BME-SBT/canbrd_hardware/parts/218-8LPS/218-8.STEP

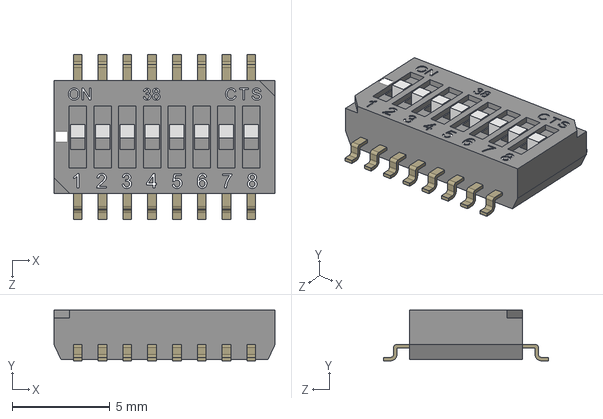
[picture p1: CAD file, 2022-01-22]
parts/218-8LPS/218-8.STEP
11.3 x 2.60 x 8.44 mm
