BME-SBT/canbrd_hardware/parts/Dc56-11.stp

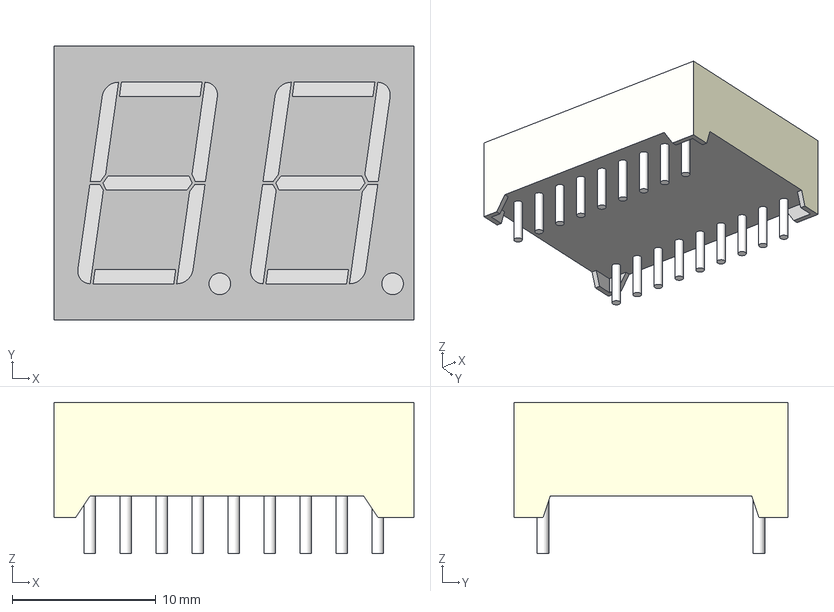
[picture p2: CAD file, 2022-10-08]
parts/Dc56-11.stp
25.0 x 19.0 x 10.5 mm
