BME-SBT/canbrd_hardware/parts/Littelfuse-154/0154.500DR.STEP

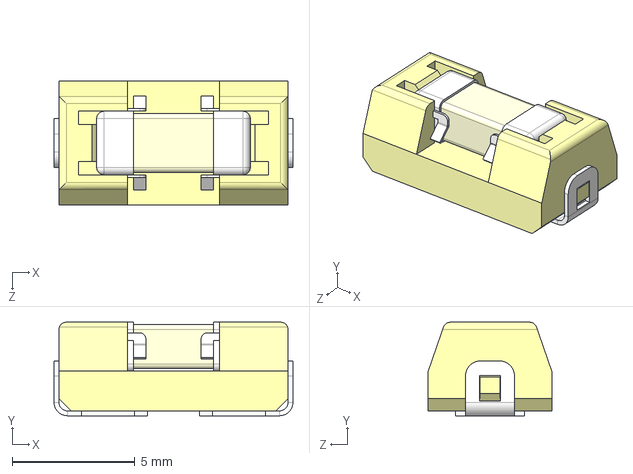
[picture p3: CAD file, 2022-01-22]
parts/Littelfuse-154/0154.500DR.STEP
9.73 x 3.81 x 5.03 mm
