BME-SBT/canbrd_hardware/parts/LTD-470/LTD-4708G.step

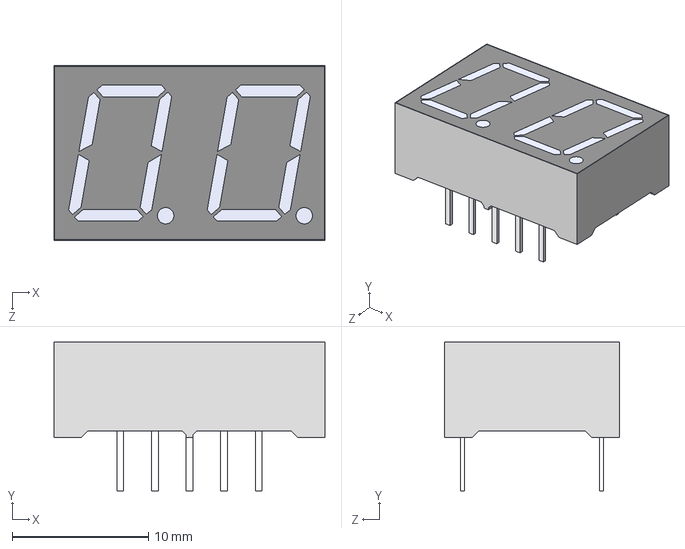
[picture p4: CAD file, 2022-01-22]
parts/LTD-470/LTD-4708G.step
19.9 x 10.9 x 12.8 mm
