BME-SBT/canbrd_hardware/parts/PTS815-SJ/PTS815SJM250SMTRLFS.stp

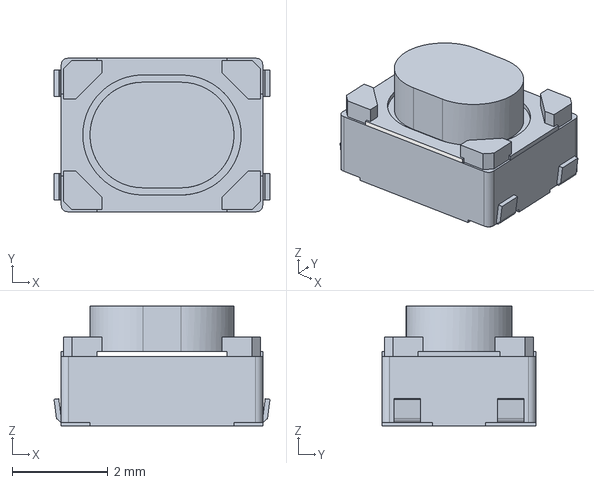
[picture p5: CAD file, 2022-01-22]
parts/PTS815-SJ/PTS815SJM250SMTRLFS.stp
4.50 x 3.20 x 2.50 mm
