BME-SBT/canbrd_hardware/parts/RFM-0505S/RFM-0505S.step

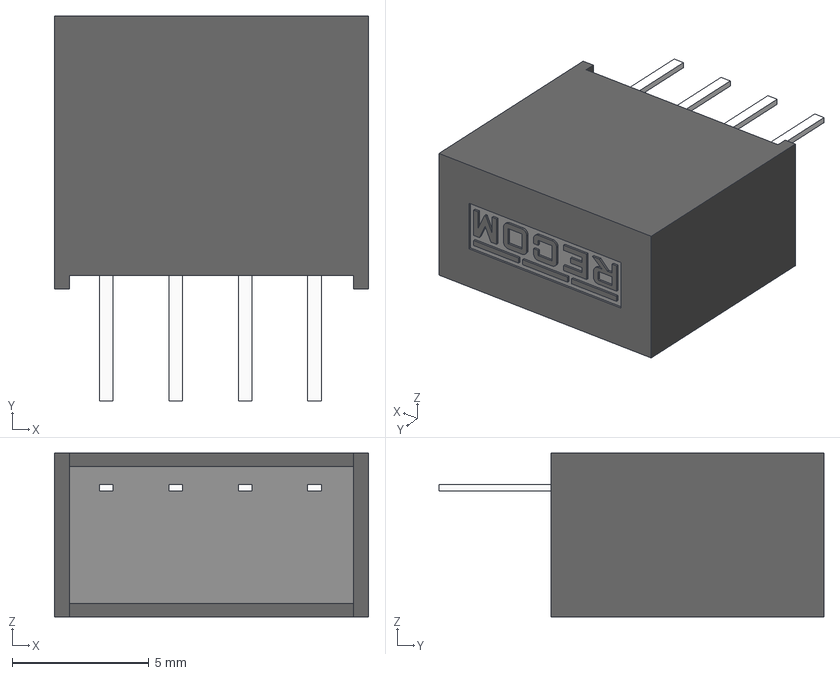
[picture p6: CAD file, 2022-05-23]
parts/RFM-0505S/RFM-0505S.step
11.5 x 14.1 x 6.00 mm
