BME-SBT/canbrd_hardware/parts/RP2040/RP2040.step

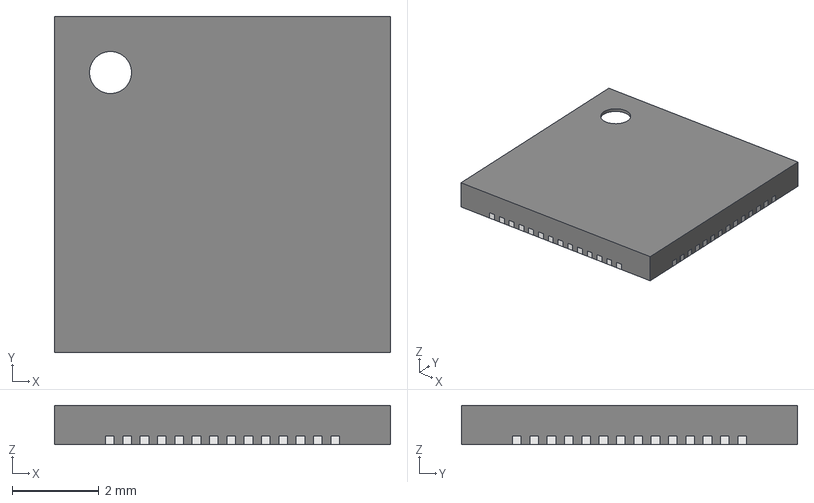
[picture p7: CAD file, 2022-01-22]
parts/RP2040/RP2040.step
7.75 x 7.75 x 0.901 mm
Open_CASCADE_STEP_translator_6.8_5.1
Open_CASCADE_STEP_translator_6.8_5.2.1
Thermal_Shape
Open_CASCADE_STEP_translator_6.8_5.4.1 x 56
