BME-SBT/canbrd_hardware/parts/SIC463/SiC462ED-T1-GE3.stp

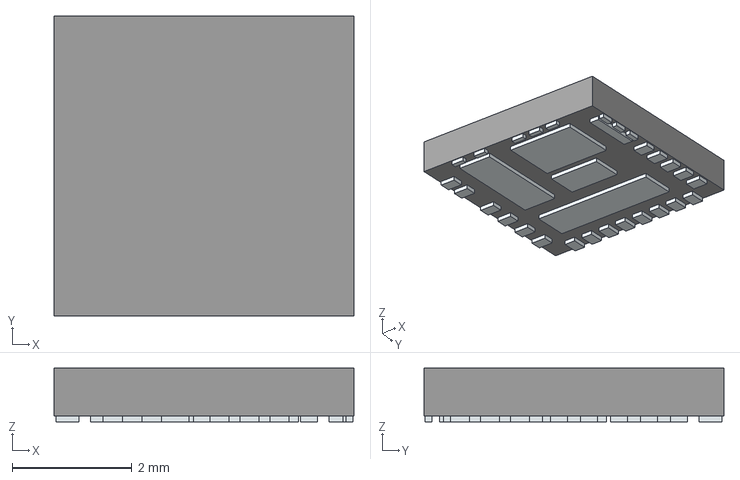
[picture p8: CAD file, 2022-01-28]
parts/SIC463/SiC462ED-T1-GE3.stp
5.00 x 5.00 x 0.9 mm
Pins
