BME-SBT/canbrd_hardware/parts/TBU-CA/tbu-ca-color.step

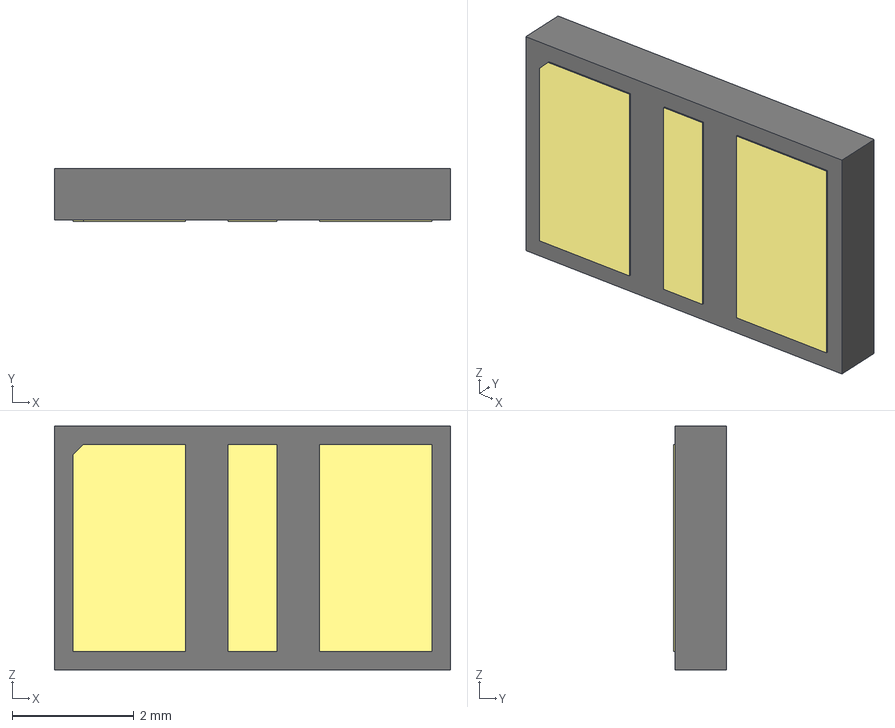
[picture p9: CAD file, 2022-02-24]
parts/TBU-CA/tbu-ca-color.step
6.50 x 0.875 x 4.00 mm
