BME-SBT/canbrd_hardware/parts/NRS5040T3R3NMGJ.stp

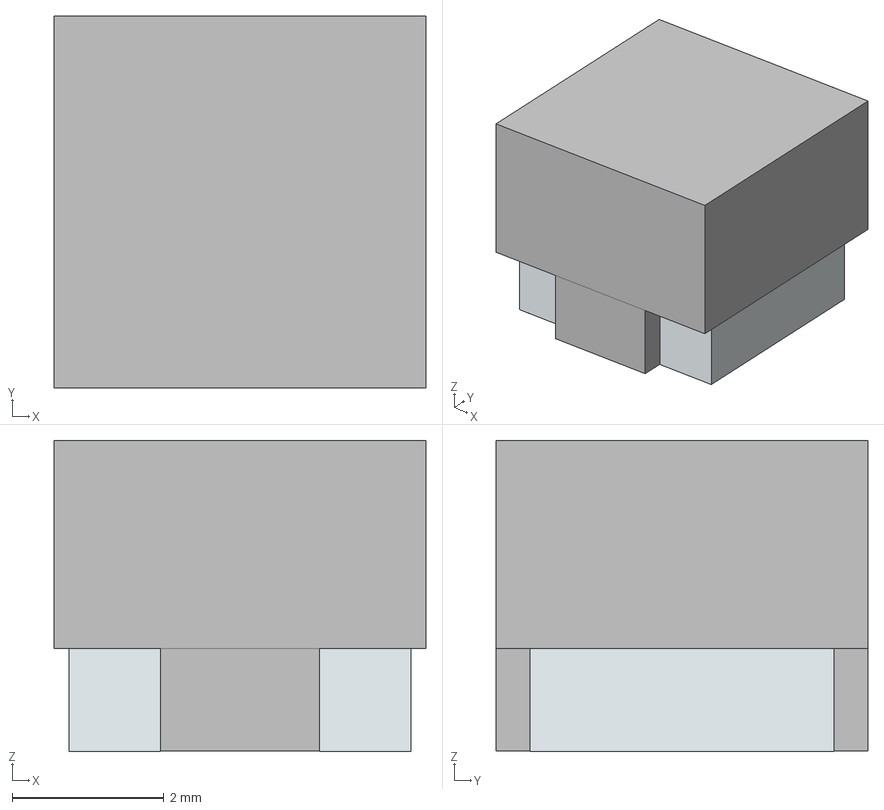
[picture p10: CAD file, 2022-02-24]
parts/NRS5040T3R3NMGJ.stp
4.90 x 4.90 x 4.10 mm
solidBody
solidLead
