BME-SBT/canbrd_hardware/parts/ASPI-0630HI.STEP

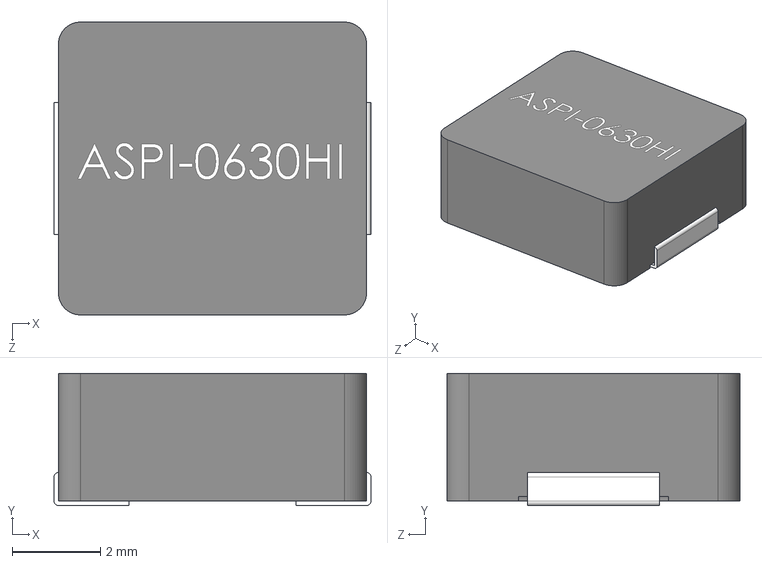
[picture p11: CAD file, 2022-02-24]
parts/ASPI-0630HI.STEP
7.20 x 3.00 x 6.65 mm
