BME-SBT/canbrd_hardware/parts/ASPIAIG-S4035.STEP

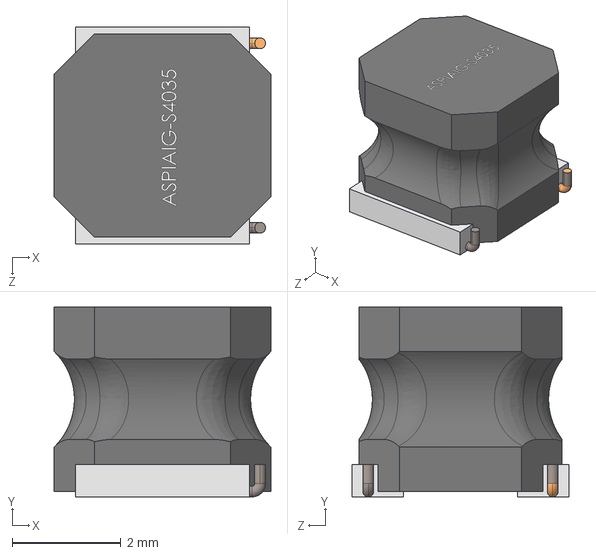
[picture p12: CAD file, 2022-02-24]
parts/ASPIAIG-S4035.STEP
4.00 x 3.50 x 4.00 mm
