BME-SBT/canbrd_hardware/parts/STP_WL-T7DS_0_39 (rev1).stp

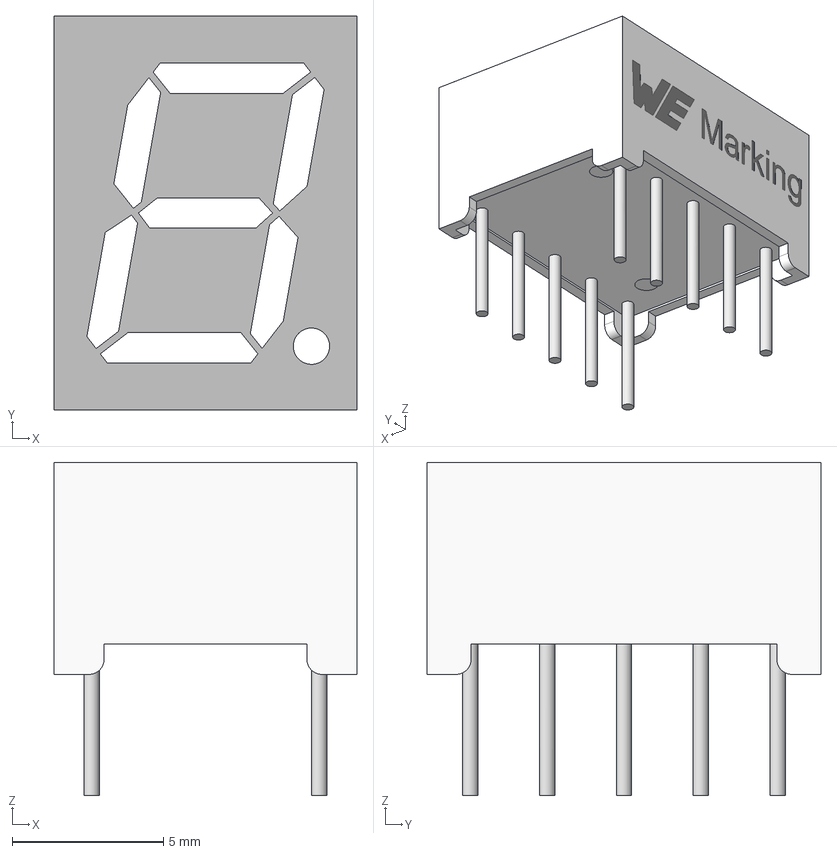
[picture p13: CAD file, 2022-01-28]
parts/STP_WL-T7DS_0_39 (rev1).stp
10.0 x 13.0 x 11.0 mm
Housing
PCB
Glue
