BME-SBT/canbrd_hardware/parts/MAX17634/MAX17634BATP_.step

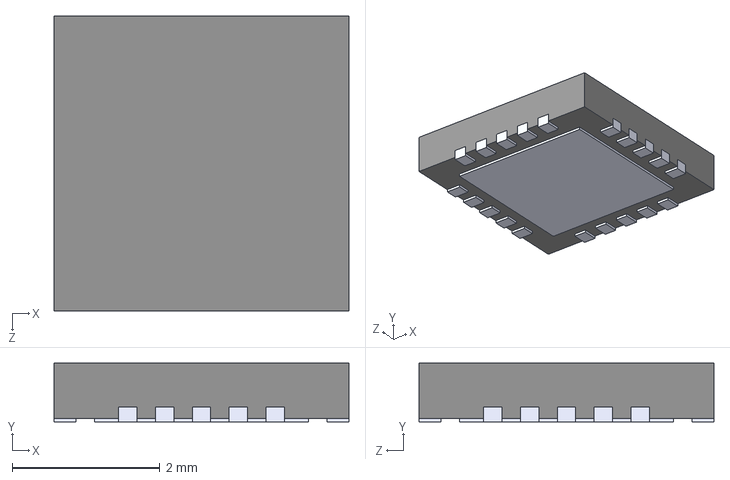
[picture p14: CAD file, 2022-02-24]
parts/MAX17634/MAX17634BATP_.step
4.00 x 0.8 x 4.00 mm
