BME-SBT/canbrd_hardware/(list of files, cad)

Other CAD files:
parts/TBU-CA/tbu-ca.stp
parts/SIC463/SiC462ED-T1-GE3.stl
