BME-SBT/canbrd_hardware/canbrd.pdf

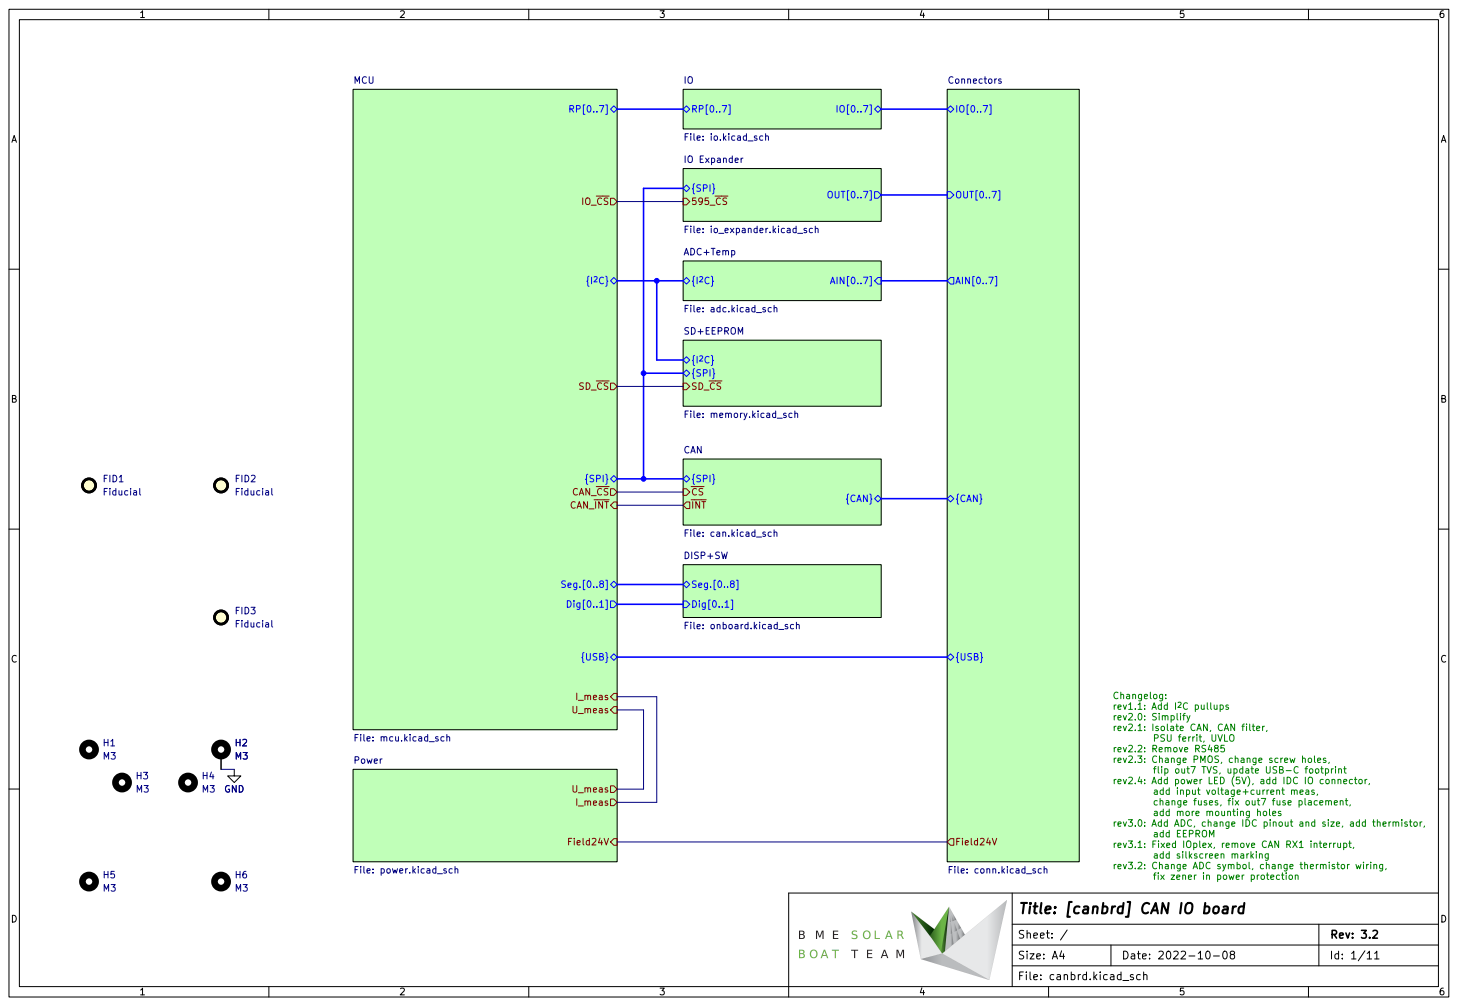
[picture p15: page 1]

rev1.1: Add I^{2}C pullups
rev2.0: Simplify
rev2.1: Isolate CAN, CAN filter,
PSU ferrit, UVLO
rev2.2: Remove RS485
rev2.3: Change PMOS, change screw holes,
flip out7 TVS, update USB-C footprint
rev2.4: Add power LED (5V), add IDC IO connector,
add input voltage+current meas,
change fuses, fix out7 fuse placement,
add more mounting holes
rev3.0: Add ADC, change IDC pinout and size, add thermistor,
add EEPROM
rev3.1: Fixed IOplex, remove CAN RX1 interrupt,
add silkscreen marking
rev3.2: Change ADC symbol, change thermistor wiring,

fix zener in power protection GND

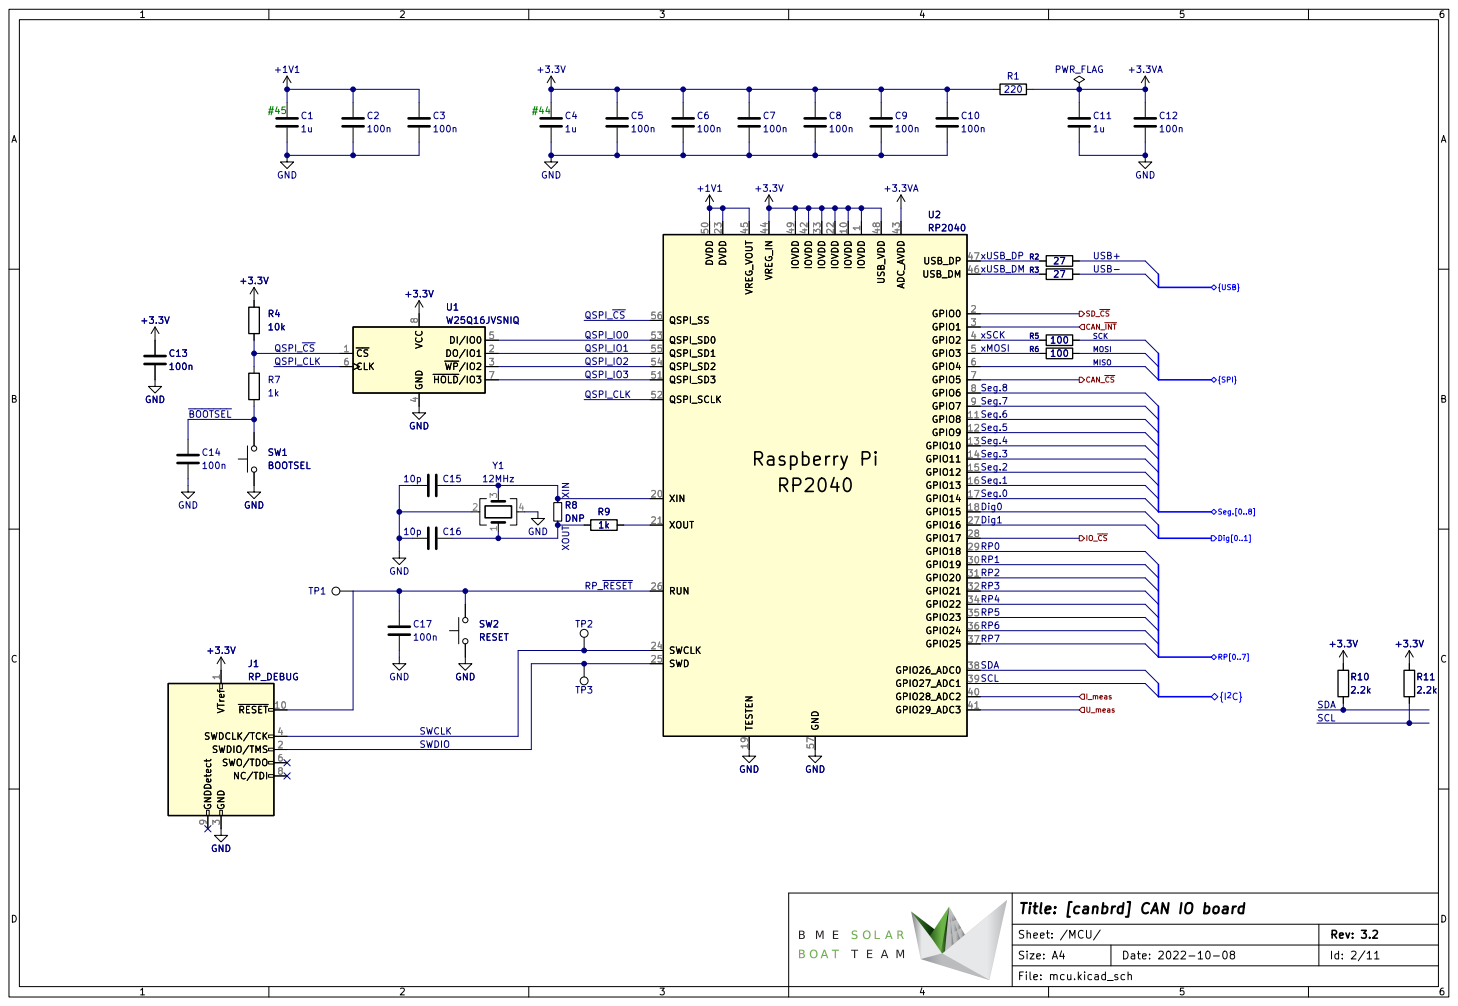
[picture p16: page 2]

1 IOVDD 10 GPIO8 11 GPIO9 12 GPIO10 13 GPIO11 14 GPIO12 15 GPIO13 16 GPIO14 17 GPIO15 18 TESTEN 19 GPIO0 2 XIN 20 XOUT 21 IOVDD 22 DVDD 23 SWCLK 24 SWD 25 RUN 26 GPIO16 27 GPIO17 28 GPIO18 29 GPIO1 3 GPIO19 30 GPIO20 31 GPIO21 32 IOVDD 33 GPIO22 34 GPIO23 35 GPIO24 36 GPIO25 37 GPIO26_ADC0 38 GPIO27_ADC1 39 GPIO2 4 GPIO28_ADC2 40 GPIO29_ADC3 41 IOVDD 42 ADC_AVDD 43 VREG_IN 44 VREG_VOUT 45 USB_DM 46 USB_DP 47 USB_VDD 48 IOVDD 49 GPIO3 5 DVDD 50 QSPI_SD3 51 QSPI_SCLK 52 QSPI_SD0 53 QSPI_SD2 54 QSPI_SD1 55 QSPI_SS 56 GND 57 GPIO4 6 GPIO5 7 GPIO6 8 GPIO7 9 U2RP2040

1 IOVDD 10 GPIO8 11 GPIO9 12 GPIO10 13 GPIO11 14 GPIO12 15 GPIO13 16 GPIO14 17 GPIO15 18 TESTEN 19 GPIO0 2 XIN 20 XOUT 21 IOVDD 22 DVDD 23 SWCLK 24 SWD 25 RUN 26 GPIO16 27 GPIO17 28 GPIO18 29 GPIO1 3 GPIO19 30 GPIO20 31 GPIO21 32 IOVDD 33 GPIO22 34 GPIO23 35 GPIO24 36 GPIO25 37 GPIO26_ADC0 38 GPIO27_ADC1 39 GPIO2 4 GPIO28_ADC2 40 GPIO29_ADC3 41 IOVDD 42 ADC_AVDD 43 VREG_IN 44 VREG_VOUT 45 USB_DM 46 USB_DP 47 USB_VDD 48 IOVDD 49 GPIO3 5 DVDD 50 QSPI_SD3 51 QSPI_SCLK 52 QSPI_SD0 53 QSPI_SD2 54 QSPI_SD1 55 QSPI_SS 56 GND 57 GPIO4 6 GPIO5 7 GPIO6 8 GPIO7 9 R4
+3.3V GND
SW1 BOOTSEL GND

4 DI/IO0 5 CLK 6 ~{HOLD}/IO3 7 VCC

3 SWDCLK/TCK 4 SWO/TDO 6 NC/TDI 8 GNDDetect 9 +3.3V GND

3 SWDCLK/TCK 4 SWO/TDO 6 NC/TDI 8 GNDDetect 9

File: mcu.kicad_sch Sheet: /MCU/

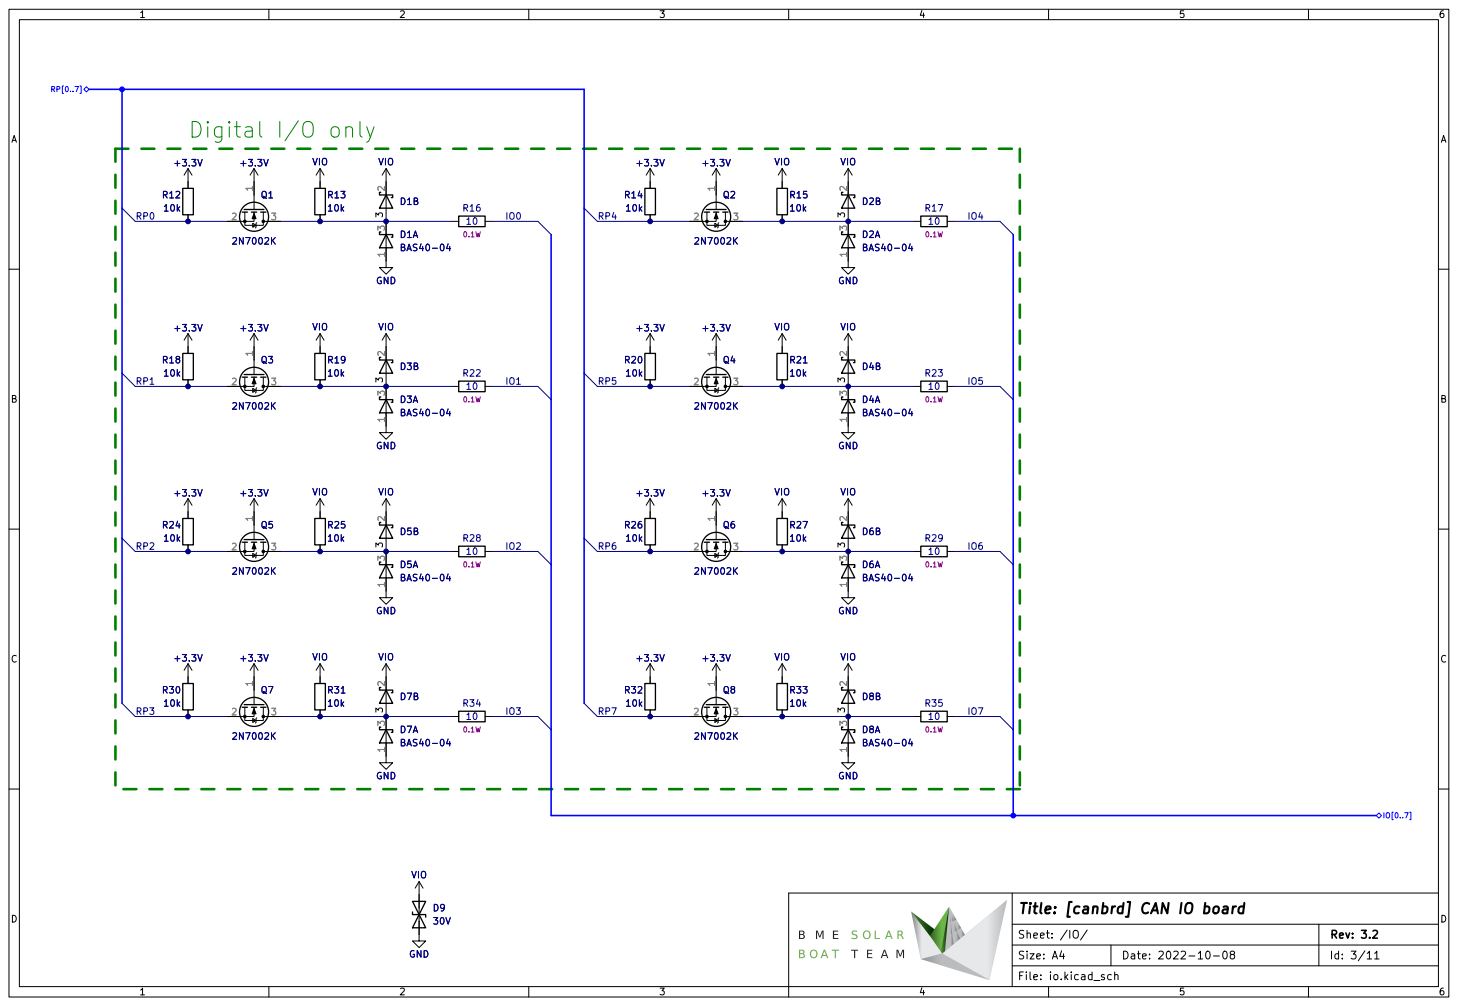
[picture p17: page 3]

File: io.kicad_sch Sheet: /IO/

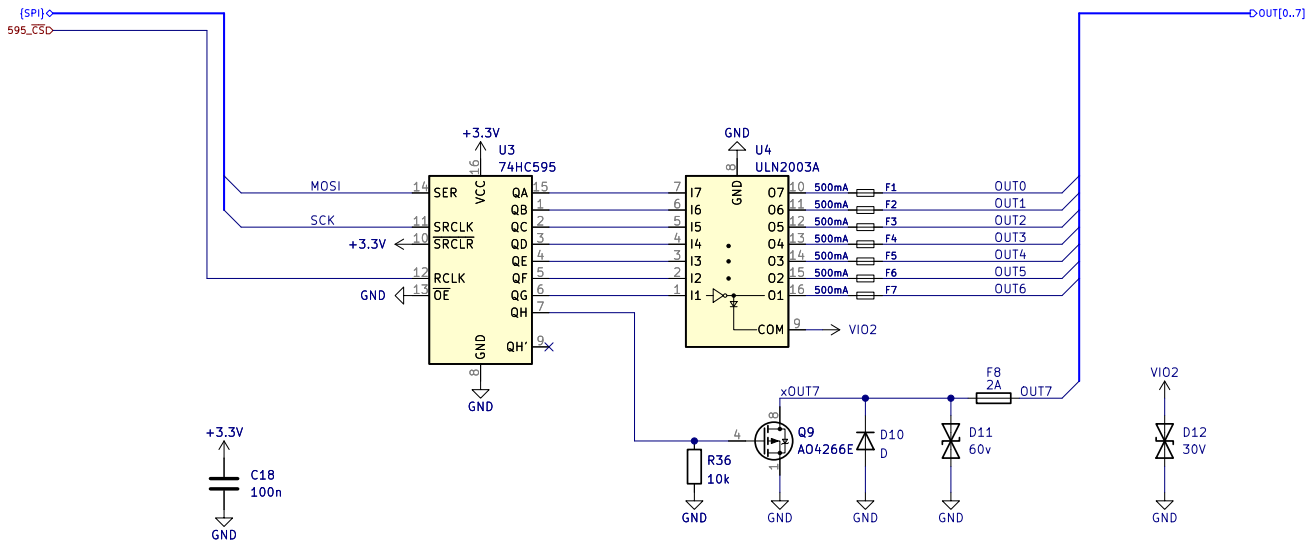
[picture p18: page 4]

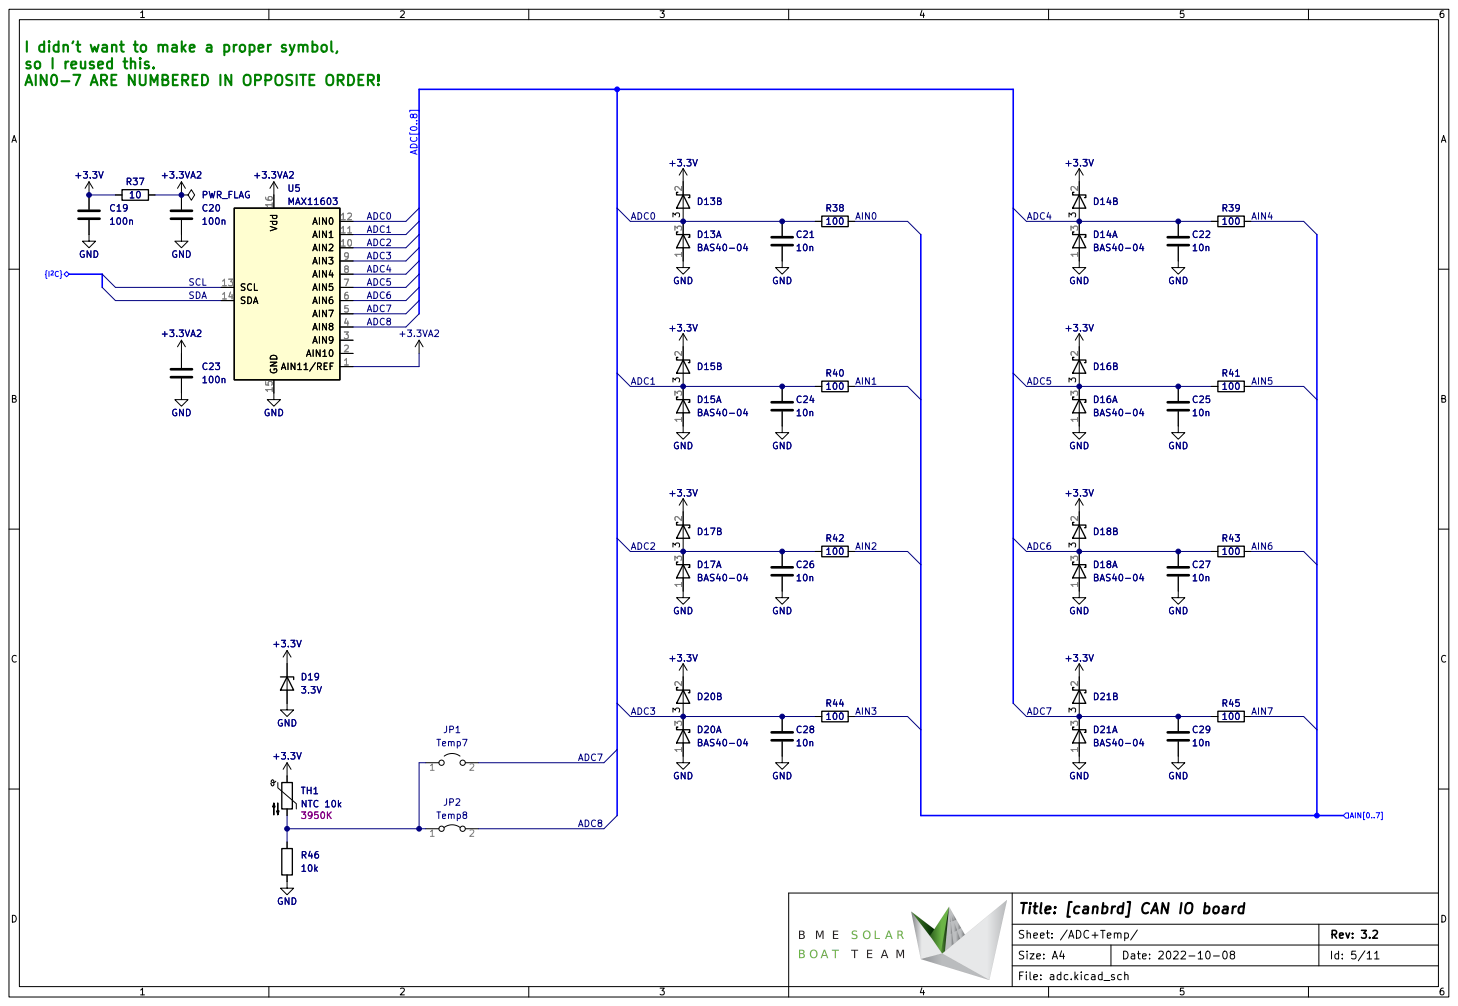
[picture p19: page 5]

I didn't want to make a proper symbol,
so I reused this.

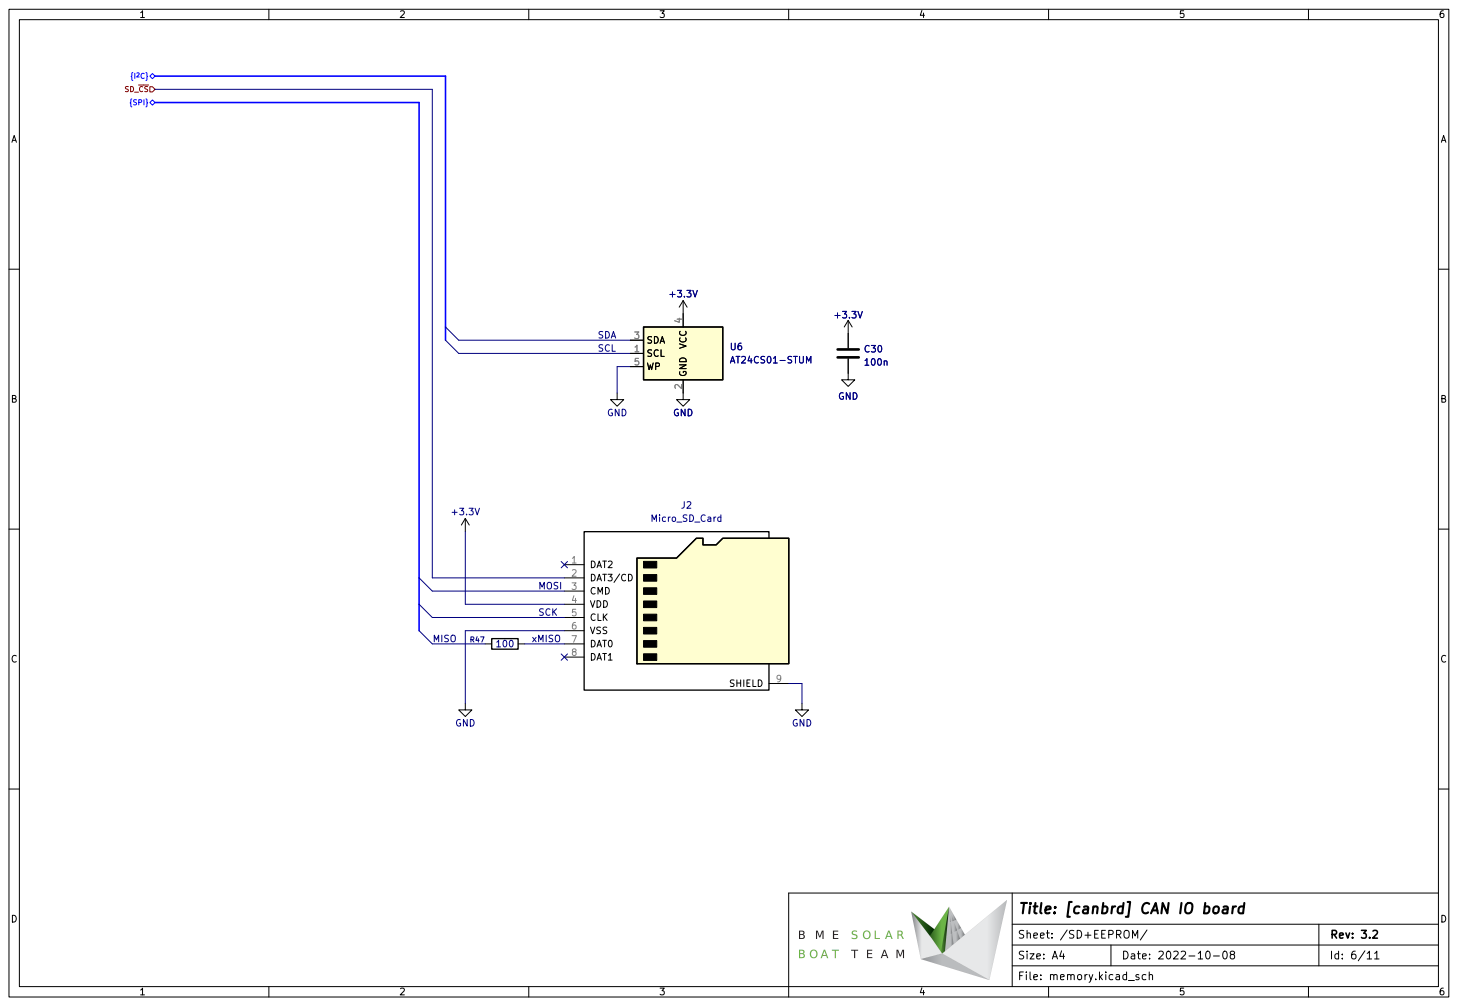
[picture p20: page 6]

File: memory.kicad_sch Sheet: /SD+EEPROM/

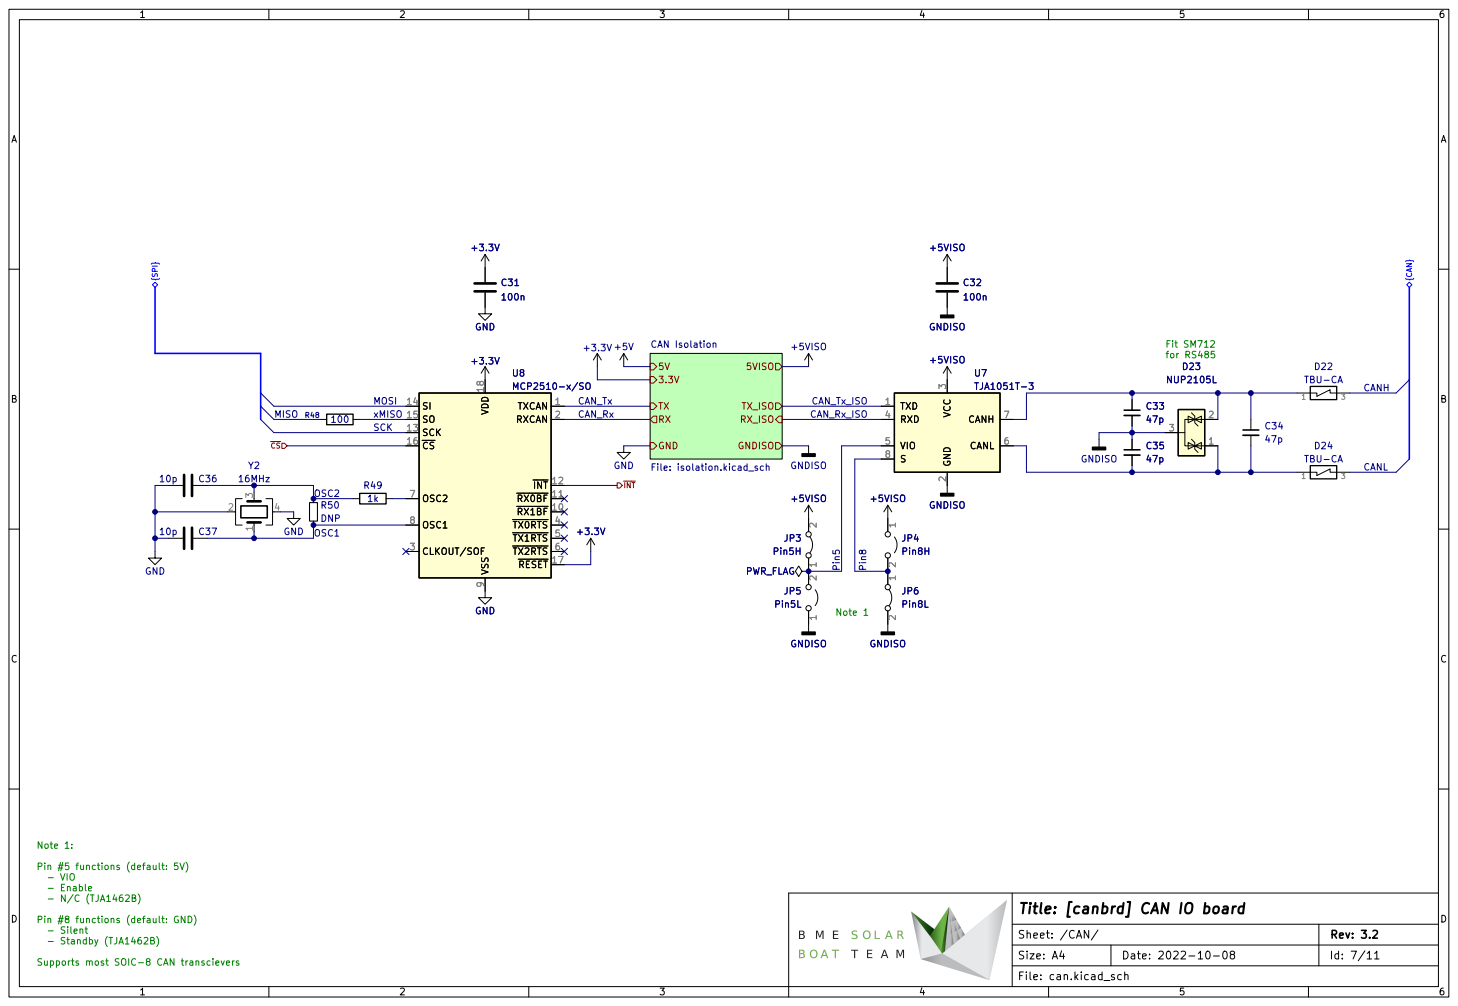
[picture p21: page 7]

for RS485 Note 1 Note 1: Pin #5 functions (default: 5V)

3 RXD 4 VIO 5 CANL 6 CANH 7 S

File: can.kicad_sch Sheet: /CAN/ GNDISO

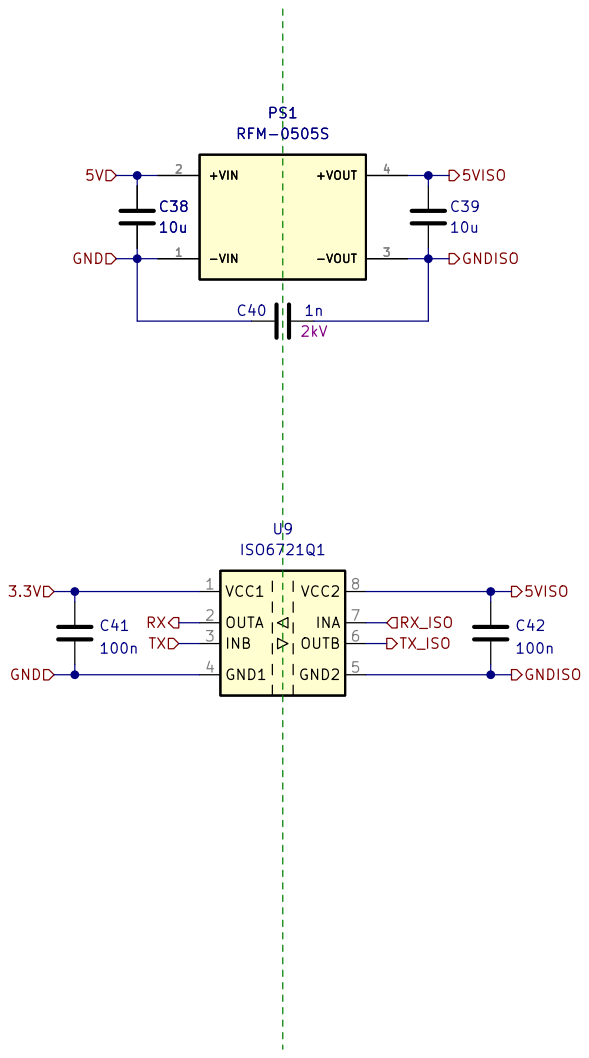
[picture p22: page 8]

File: isolation.kicad_sch Sheet: /CAN/CAN Isolation/

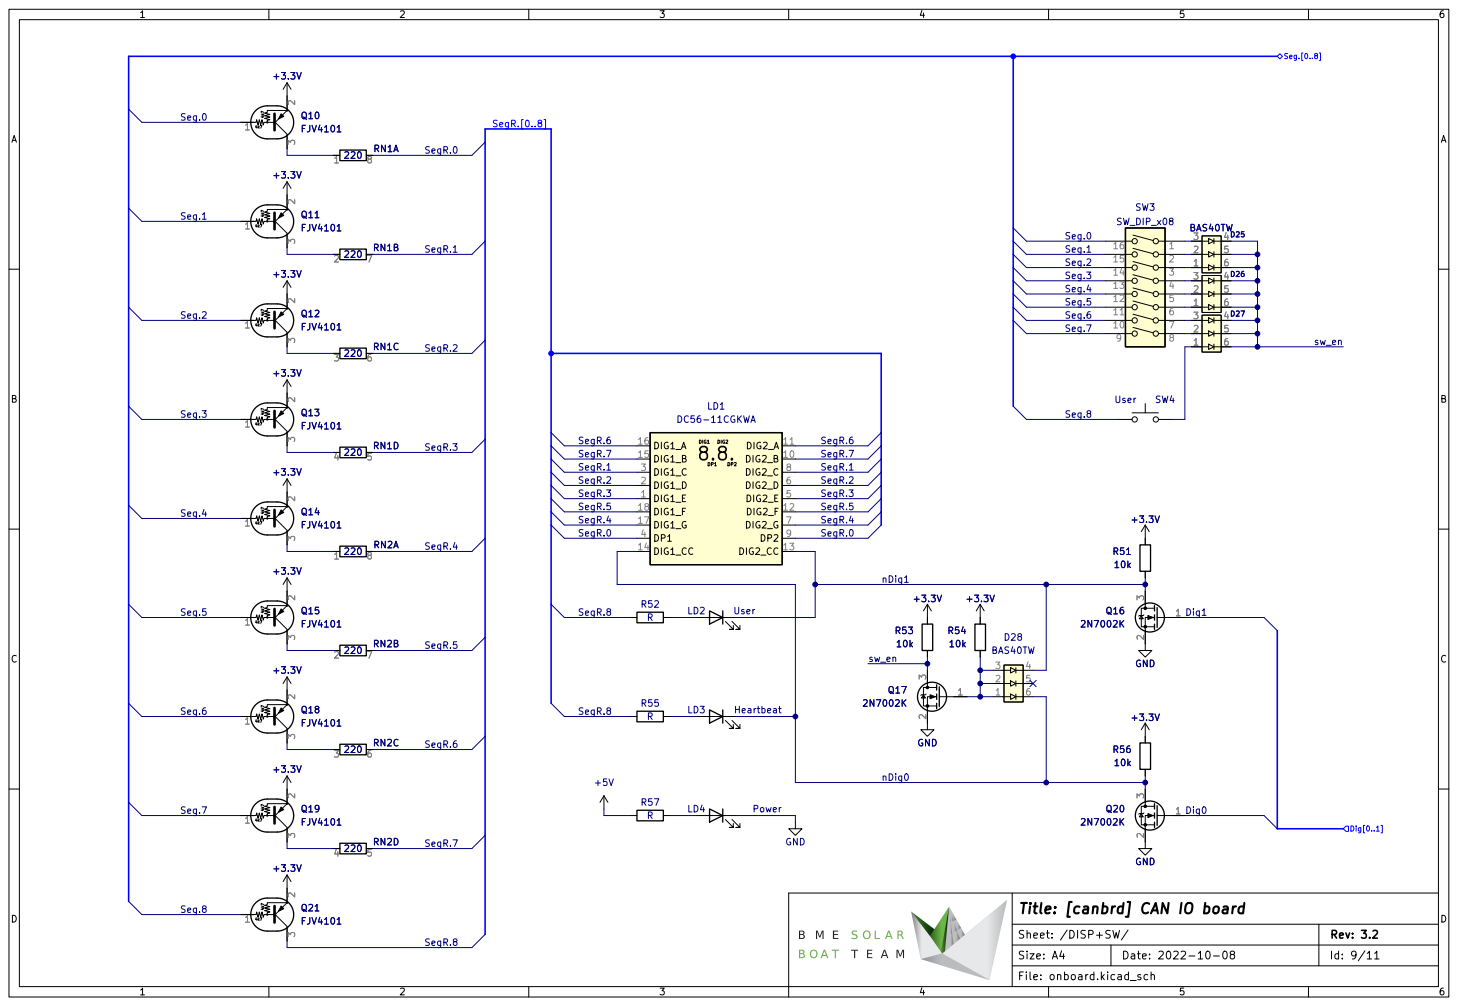
[picture p23: page 9]

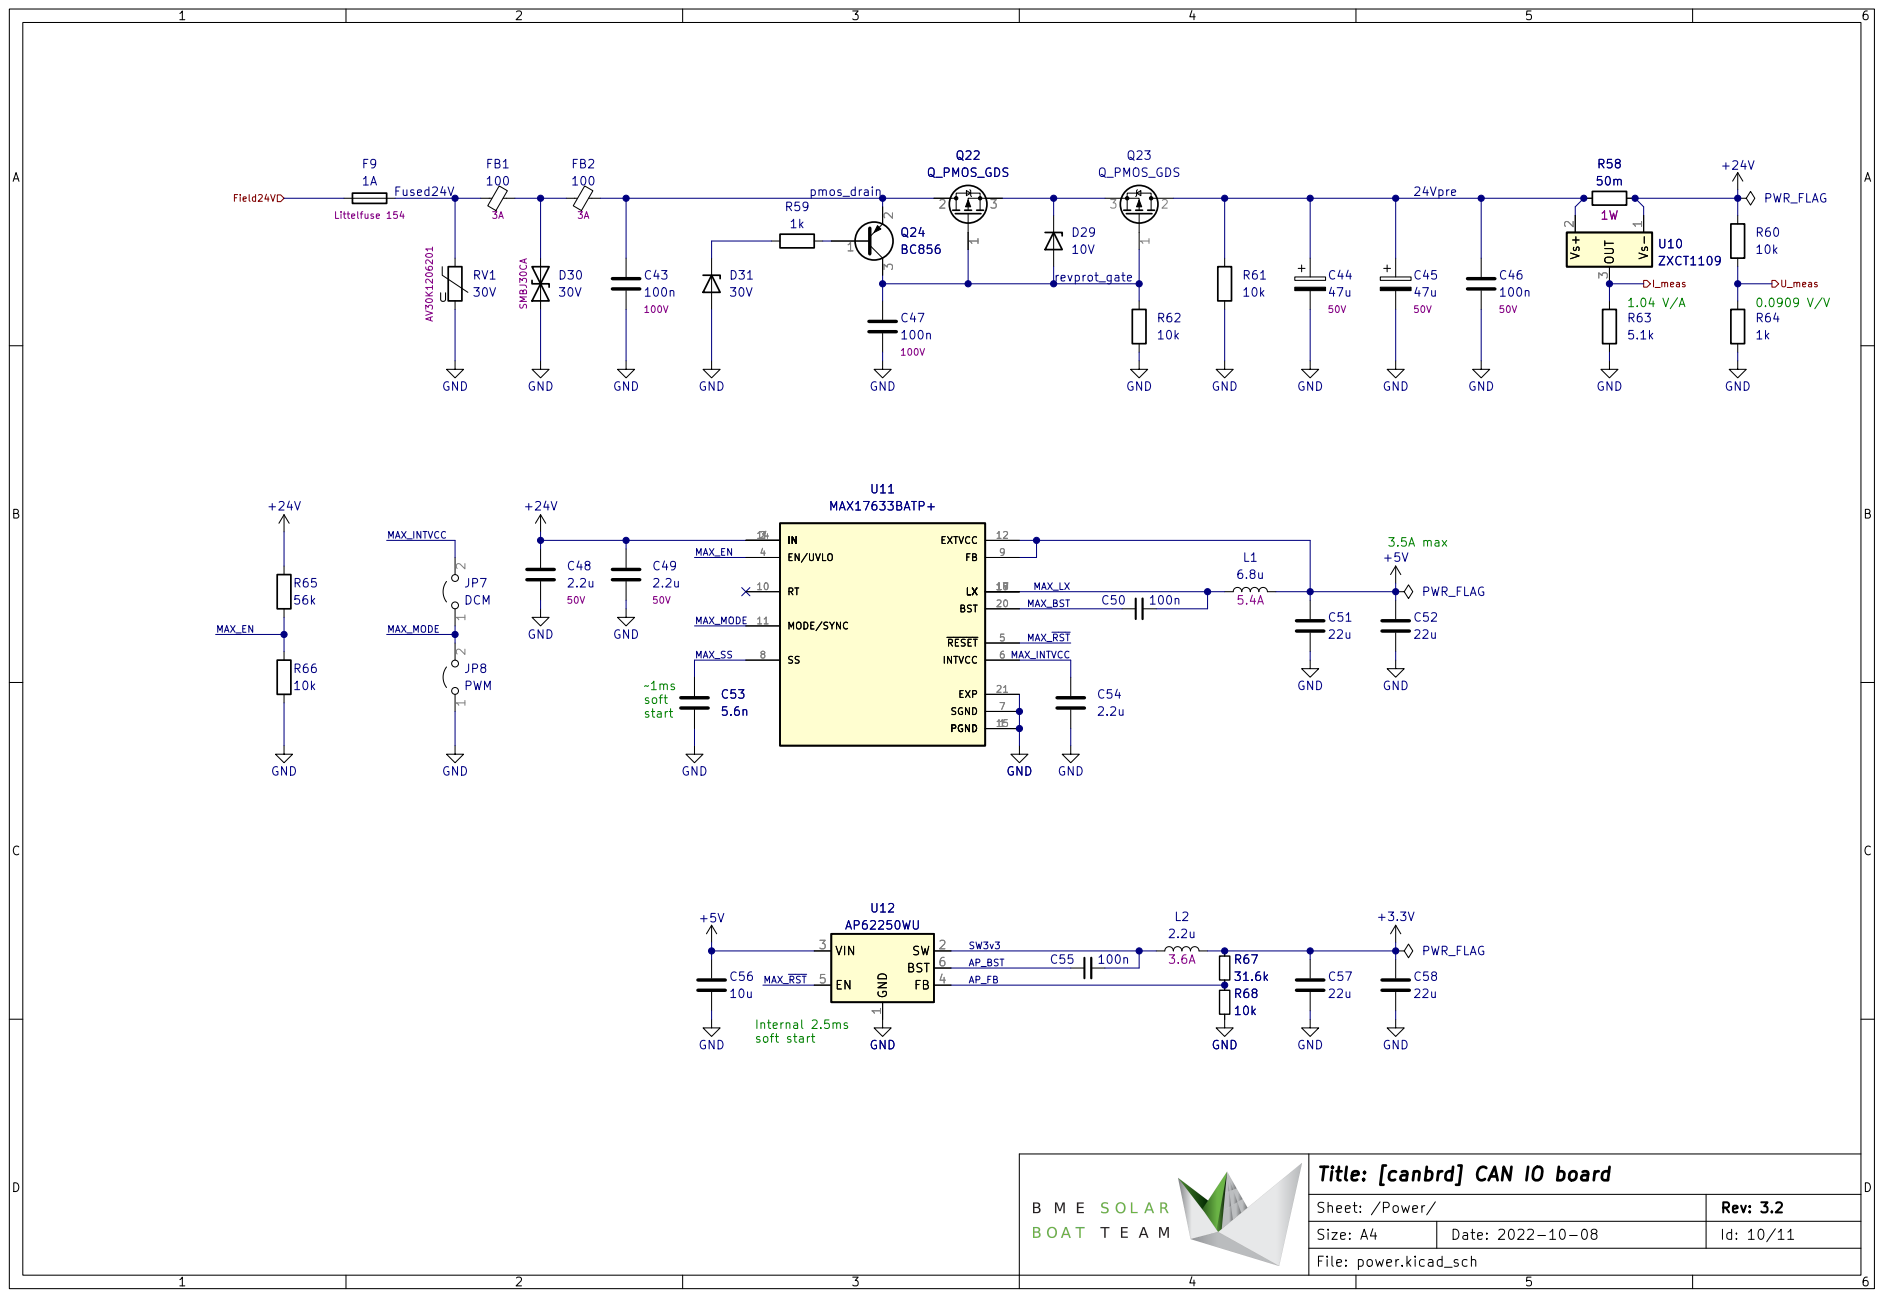
[picture p24: page 10]

File: power.kicad_sch Sheet: /Power/ C51

1 SW 2 VIN 3 FB 4 EN 5 BST 6 U12 AP62250WU

1 SW 2 VIN 3 FB 4 EN 5 BST 6 GND

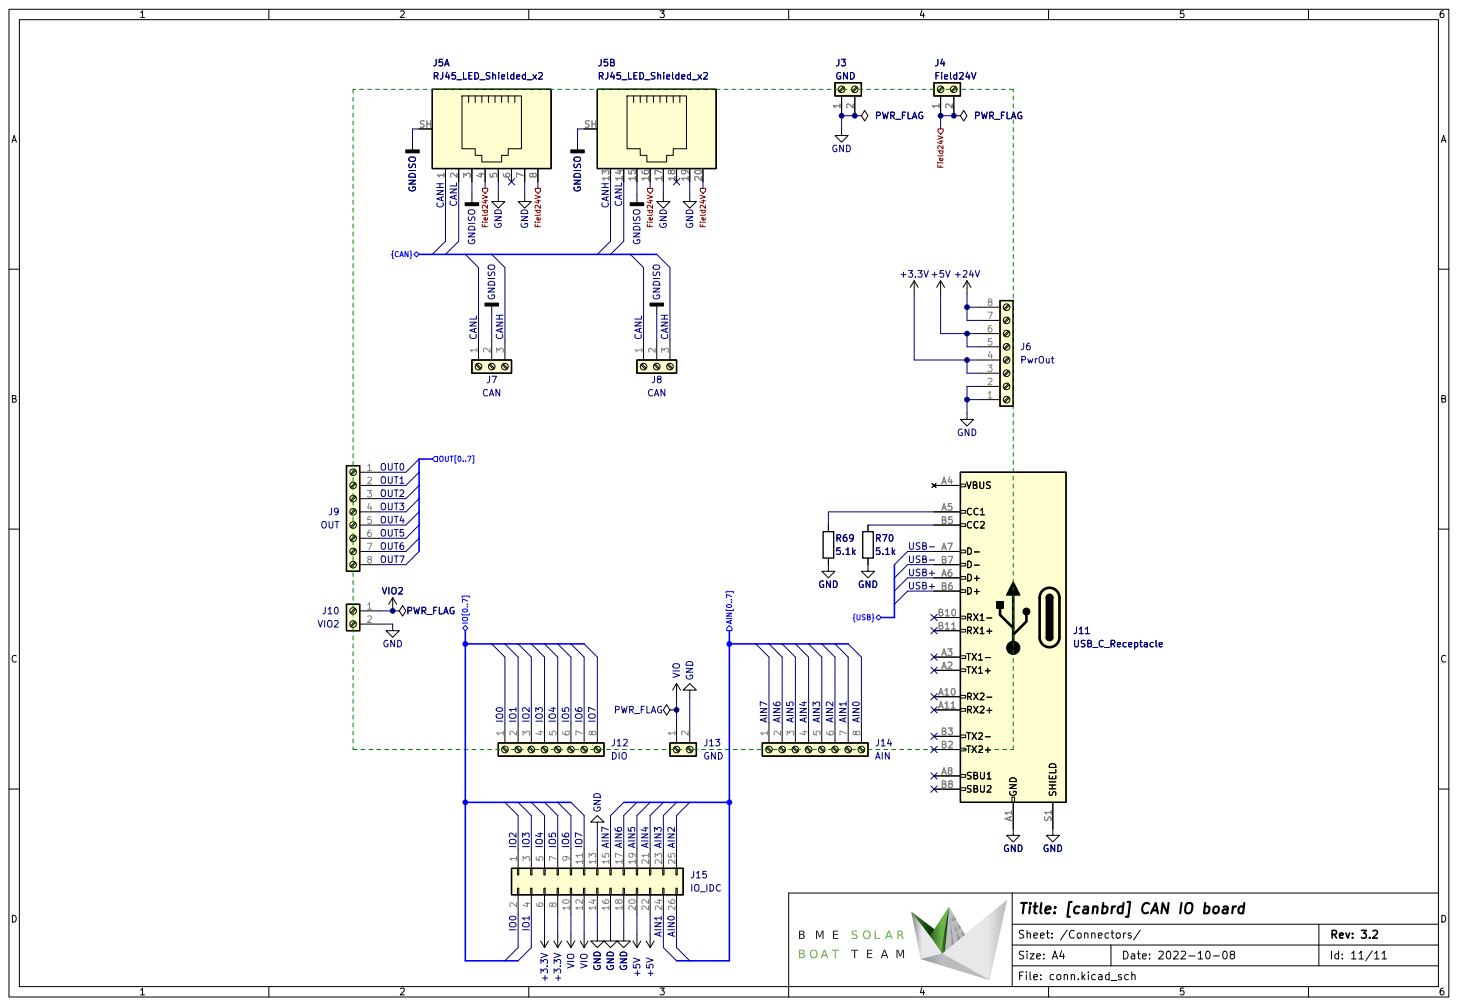
[picture p25: page 11]
