BME-SBT/canbrd_hardware/canbrd.kicad_pcb

## KiCad design canbrd.kicad_pcb (2022-06-03)

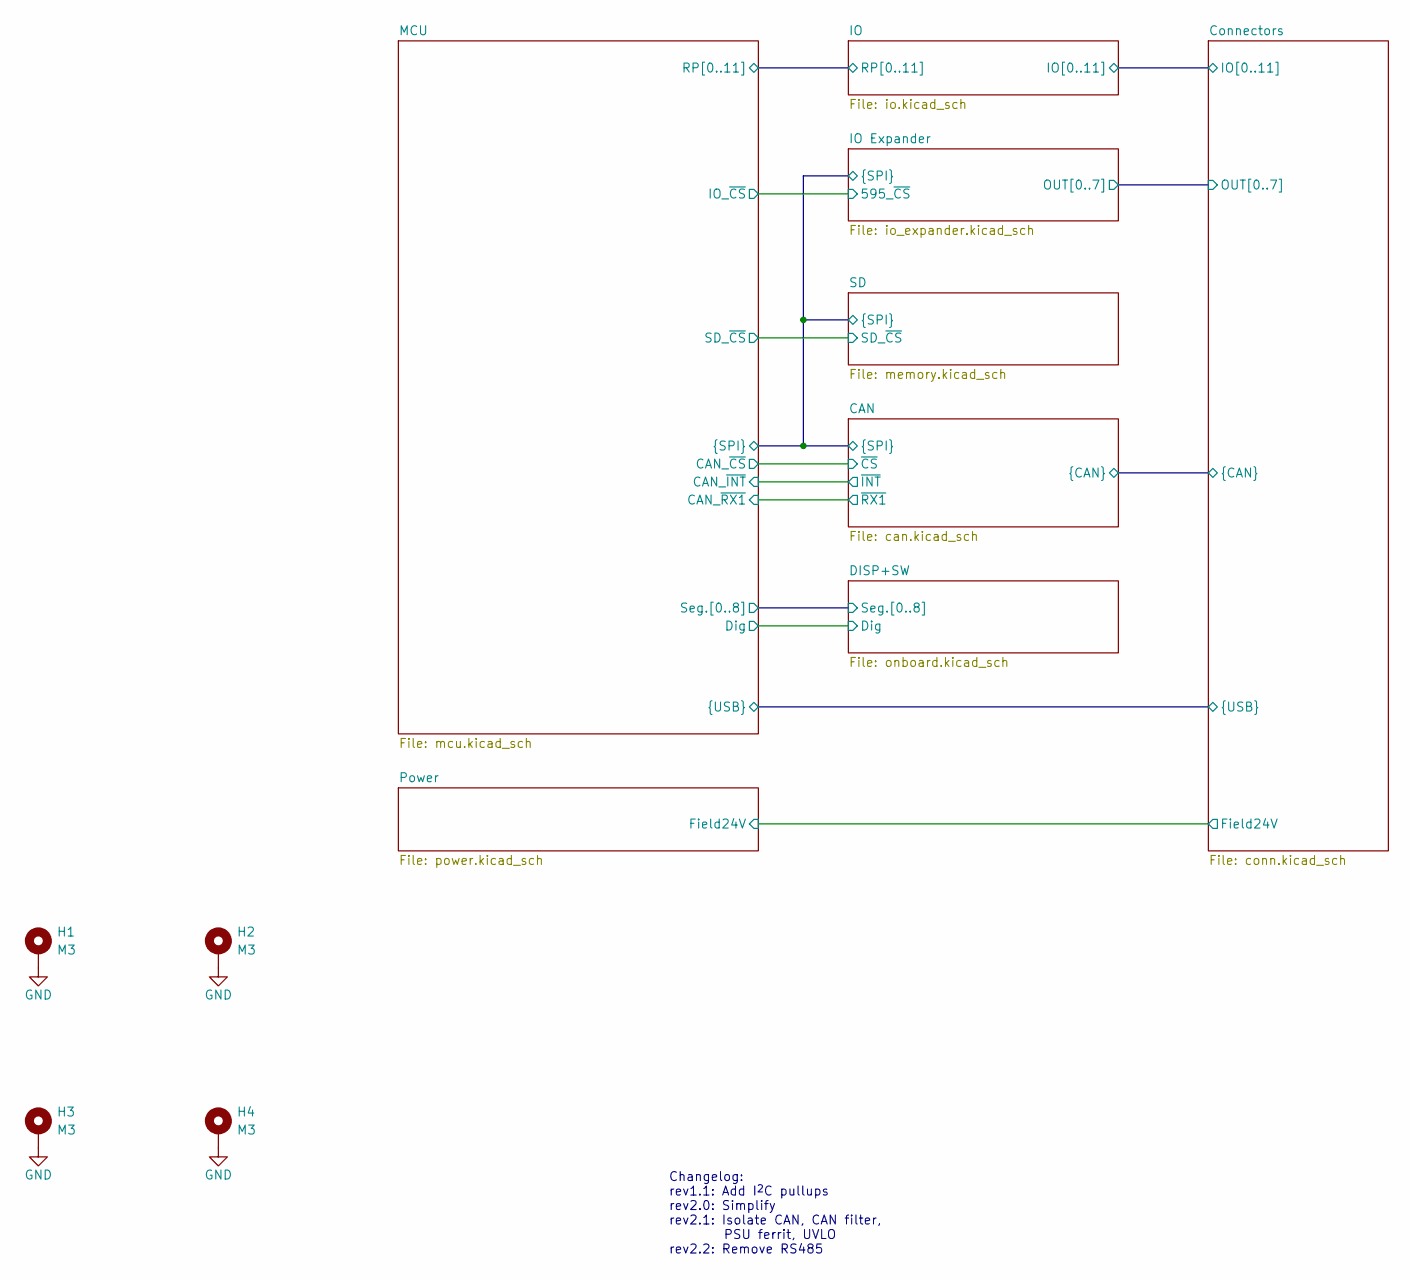
[picture p26: schematic canbrd.kicad_sch, [canbrd] CAN IO board]

Parts:
H1, H2, H3, H4: M3; MountingHole_3.2mm_M3_Pad_Via

Connections:
GND: H1.1, H2.1, H3.1, H4.1; also elsewhere on the board

Notes on the sheet:
Changelog: rev1.1: Add I^{2}C pullups rev2.0: Simplify rev2.1: Isolate CAN, CAN filter, PSU ferrit, UVLO rev2.2: Remove RS485

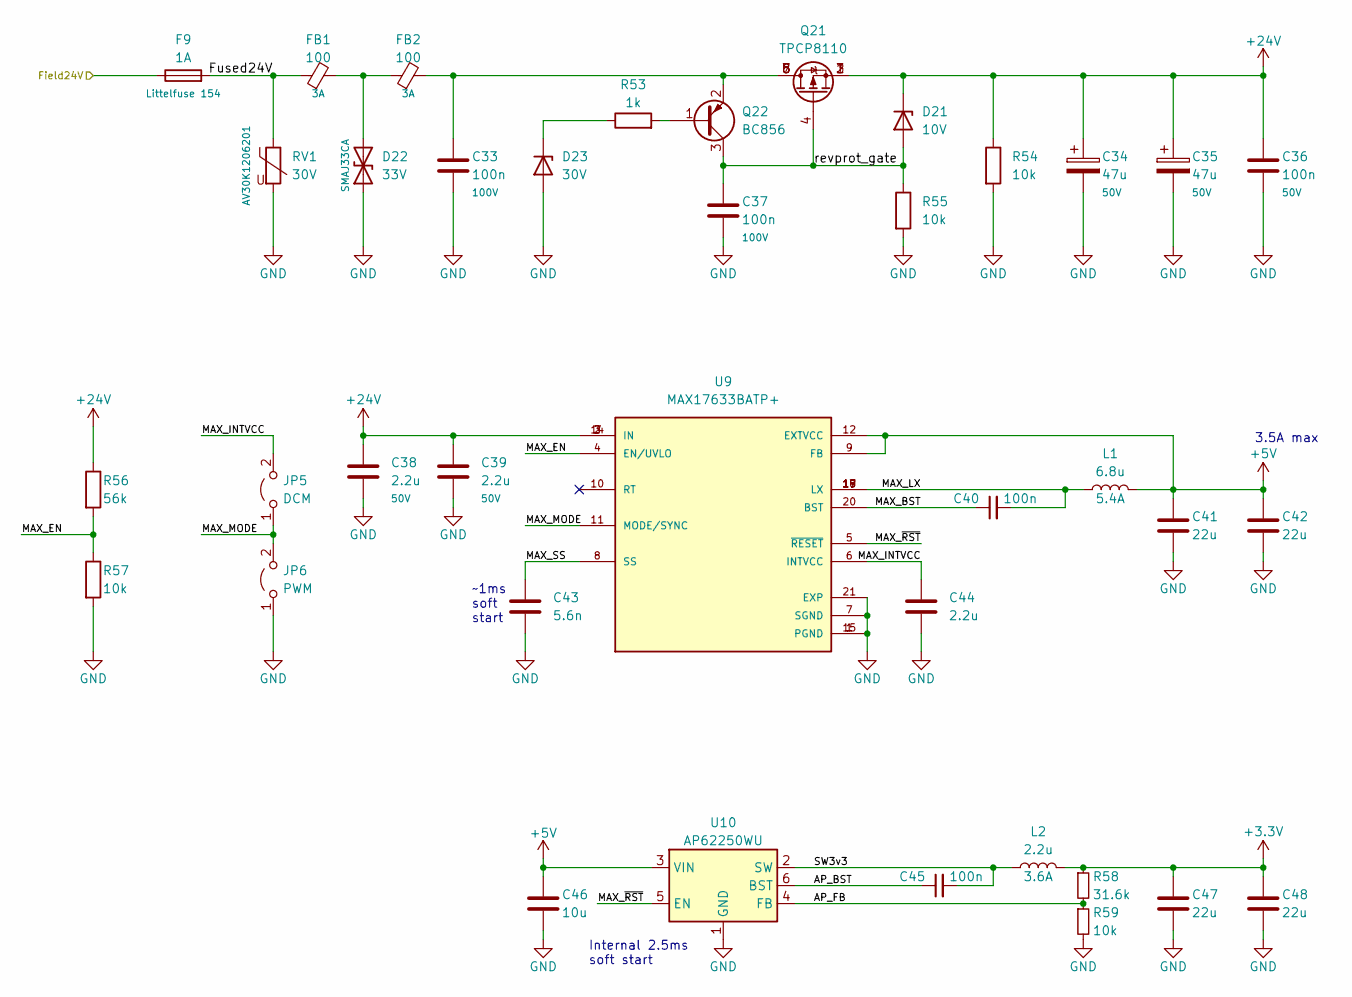
[picture p27: schematic power.kicad_sch, [canbrd] CAN IO board]

Parts:
C33, C37: 100n; C_1206_3216Metric; Voltage 100V
C34, C35: 47u; CP_Elec_8x6.5; Voltage 50V
C36: 100n; C_0805_2012Metric; Voltage 50V
C38, C39: 2.2u; C_1206_3216Metric; Voltage 50V
C40, C45: 100n; C_0603_1608Metric
C41, C42, C47, C48: 22u; C_0805_2012Metric
C43: 5.6n; C_0603_1608Metric
C44: 2.2u; C_0603_1608Metric
C46: 10u; C_0805_2012Metric
D21: 10V; D_SOD-123
D22: 33V; D_SMB
D23: 30V; D_SOD-123
F9: 1A; Littelfuse-154-2920
FB1, FB2: 100; L_1206_3216Metric
JP5: DCM; SolderJumper-2_P1.3mm_Open_TrianglePad1.0x1.5mm
JP6: PWM; SolderJumper-2_P1.3mm_Open_TrianglePad1.0x1.5mm
L1: 6.8u; L_Abracon_ASPI-0630LR
L2: 2.2u; L_Taiyo-Yuden_NR-50xx
Q21: TPCP8110; PS-8
Q22: BC856; SOT-23
R53: 1k; R_0603_1608Metric
R54, R55, R57, R59: 10k; R_0603_1608Metric
R56: 56k; R_0603_1608Metric
R58: 31.6k; R_0603_1608Metric
RV1: 30V; R_1206_3216Metric
U9: MAX17633BATP+; TQFN20-EP
U10: AP62250WU; TSOT26

Connections:
+3V3: C47.1, C48.1, L2.2, R58.1; also elsewhere on the board
+5V: C41.1, C42.1, C46.1, L1.2, U9.9 (FB), U9.12 (EXTVCC), U10.3 (VIN); also elsewhere on the board
+24V: C34.1, C35.1, C36.1, C38.1, C39.1, D21.1 (K), Q21.1 (S), Q21.2 (S), Q21.3 (S), R54.1, R56.1, U9.2 (IN), U9.3 (IN), U9.14 (IN); also elsewhere on the board
/Connectors/Field24V: F9.1; also elsewhere on the board
/Power/AP_BST: C45.1, U10.6 (BST)
/Power/AP_FB: R58.2, R59.1, U10.4 (FB)
/Power/Fused24V: F9.2, FB1.1, RV1.1
/Power/MAX_BST: C40.1, U9.20 (BST)
/Power/MAX_EN: R56.2, R57.1, U9.4 (EN/UVLO)
/Power/MAX_INTVCC: C44.1, JP5.2 (B), U9.6 (INTVCC)
/Power/MAX_LX: C40.2, L1.1, U9.17 (LX), U9.18 (LX), U9.19 (LX)
/Power/MAX_MODE: JP5.1 (A), JP6.2 (B), U9.11 (MODE/SYNC)
/Power/MAX_SS: C43.1, U9.8 (SS)
/Power/MAX_~RST: U9.5 (~RESET), U10.5 (EN)
/Power/SW3v3: C45.2, L2.1, U10.2 (SW)
/Power/revprot_gate: C37.1, D21.2 (A), Q21.4 (G), Q22.3 (C), R55.1
GND: C33.2, C34.2, C35.2, C36.2, C37.2, C38.2, C39.2, C41.2, C42.2, C43.2, C44.2, C46.2, C47.2, C48.2, D22.1 (A1), D23.2 (A), JP6.1 (A), R54.2, R55.2, R57.2, R59.2, RV1.2, U9.1 (PGND), U9.7 (SGND), U9.15 (PGND), U9.21 (EXP), U10.1 (GND); also elsewhere on the board
unnamed: C33.1, FB2.2, Q21.5 (D), Q21.6 (D), Q21.7 (D), Q21.8 (D), Q22.2 (E)
unnamed: D22.2 (A2), FB1.2, FB2.1
unnamed: D23.1 (K), R53.1
unnamed: Q22.1 (B), R53.2

Notes on the sheet:
~1ms soft start
3.5A max
Internal 2.5ms soft start

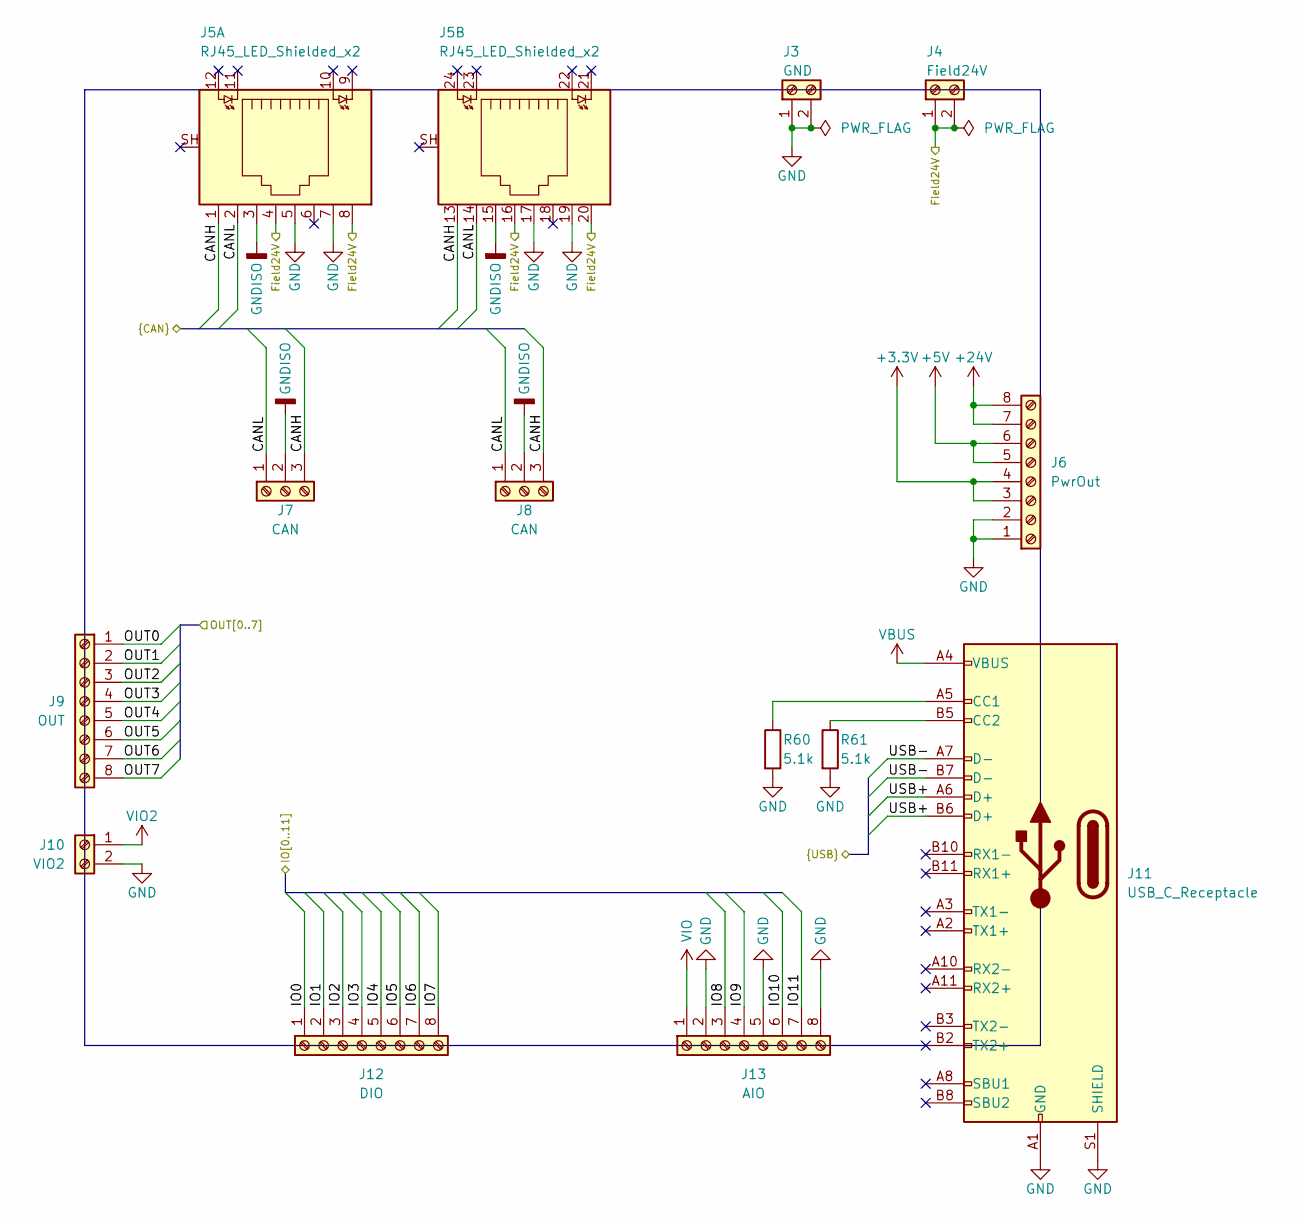
[picture p28: schematic conn.kicad_sch, [canbrd] CAN IO board]

Parts:
J3: GND; NH0210x0xxxxG
J4: Field24V; NH0210x0xxxxG
J5: RJ45_LED_Shielded_x2; RJ45_Amphenol_RJHSE5380-02
J6: PwrOut; NH0810x0xxxxG
J7, J8: CAN; NH0310x0xxxxG
J9: OUT; NH0810x0xxxxG
J10: VIO2; NH0210x0xxxxG
J11: USB_C_Receptacle; 10132328
J12: DIO; NH0810x0xxxxG
J13: AIO; NH0810x0xxxxG
R60, R61: 5.1k; R_0603_1608Metric

Connections:
+3V3: J6.3, J6.4; also elsewhere on the board
+5V: J6.5, J6.6; also elsewhere on the board
+24V: J6.7, J6.8; also elsewhere on the board
/CAN/CANH: J5.1, J5.13, J7.3, J8.3; also elsewhere on the board
/CAN/CANL: J5.2, J5.14, J7.1, J8.1; also elsewhere on the board
/Connectors/Field24V: J4.1, J4.2, J5.4, J5.8, J5.16, J5.20; also elsewhere on the board
/Connectors/IO0: J12.1; also elsewhere on the board
/Connectors/IO1: J12.2; also elsewhere on the board
/Connectors/IO2: J12.3; also elsewhere on the board
/Connectors/IO3: J12.4; also elsewhere on the board
/Connectors/IO4: J12.5; also elsewhere on the board
/Connectors/IO5: J12.6; also elsewhere on the board
/Connectors/IO6: J12.7; also elsewhere on the board
/Connectors/IO7: J12.8; also elsewhere on the board
/Connectors/IO8: J13.3; also elsewhere on the board
/Connectors/IO9: J13.4; also elsewhere on the board
/Connectors/IO10: J13.6; also elsewhere on the board
/Connectors/IO11: J13.7; also elsewhere on the board
/Connectors/OUT0: J9.1; also elsewhere on the board
/Connectors/OUT1: J9.2; also elsewhere on the board
/Connectors/OUT2: J9.3; also elsewhere on the board
/Connectors/OUT3: J9.4; also elsewhere on the board
/Connectors/OUT4: J9.5; also elsewhere on the board
/Connectors/OUT5: J9.6; also elsewhere on the board
/Connectors/OUT6: J9.7; also elsewhere on the board
/Connectors/OUT7: J9.8; also elsewhere on the board
/Connectors/USB+: J11.A6 (D+), J11.B6 (D+); also elsewhere on the board
/Connectors/USB-: J11.A7 (D-), J11.B7 (D-); also elsewhere on the board
GND: J3.1, J3.2, J5.5, J5.7, J5.17, J5.19, J6.1, J6.2, J10.2, J11.A1 (GND), J11.A12 (GND), J11.B1 (GND), J11.B12 (GND), J11.S1 (SHIELD), J13.2, J13.5, J13.8, R60.2, R61.2; also elsewhere on the board
GNDISO: J5.3, J5.15, J7.2, J8.2; also elsewhere on the board
unnamed: J11.A5 (CC1), R60.1
unnamed: J11.B5 (CC2), R61.1
VBUS: J11.A4 (VBUS), J11.A9 (VBUS), J11.B4 (VBUS), J11.B9 (VBUS)
VIO: J13.1; also elsewhere on the board
VIO2: J10.1; also elsewhere on the board

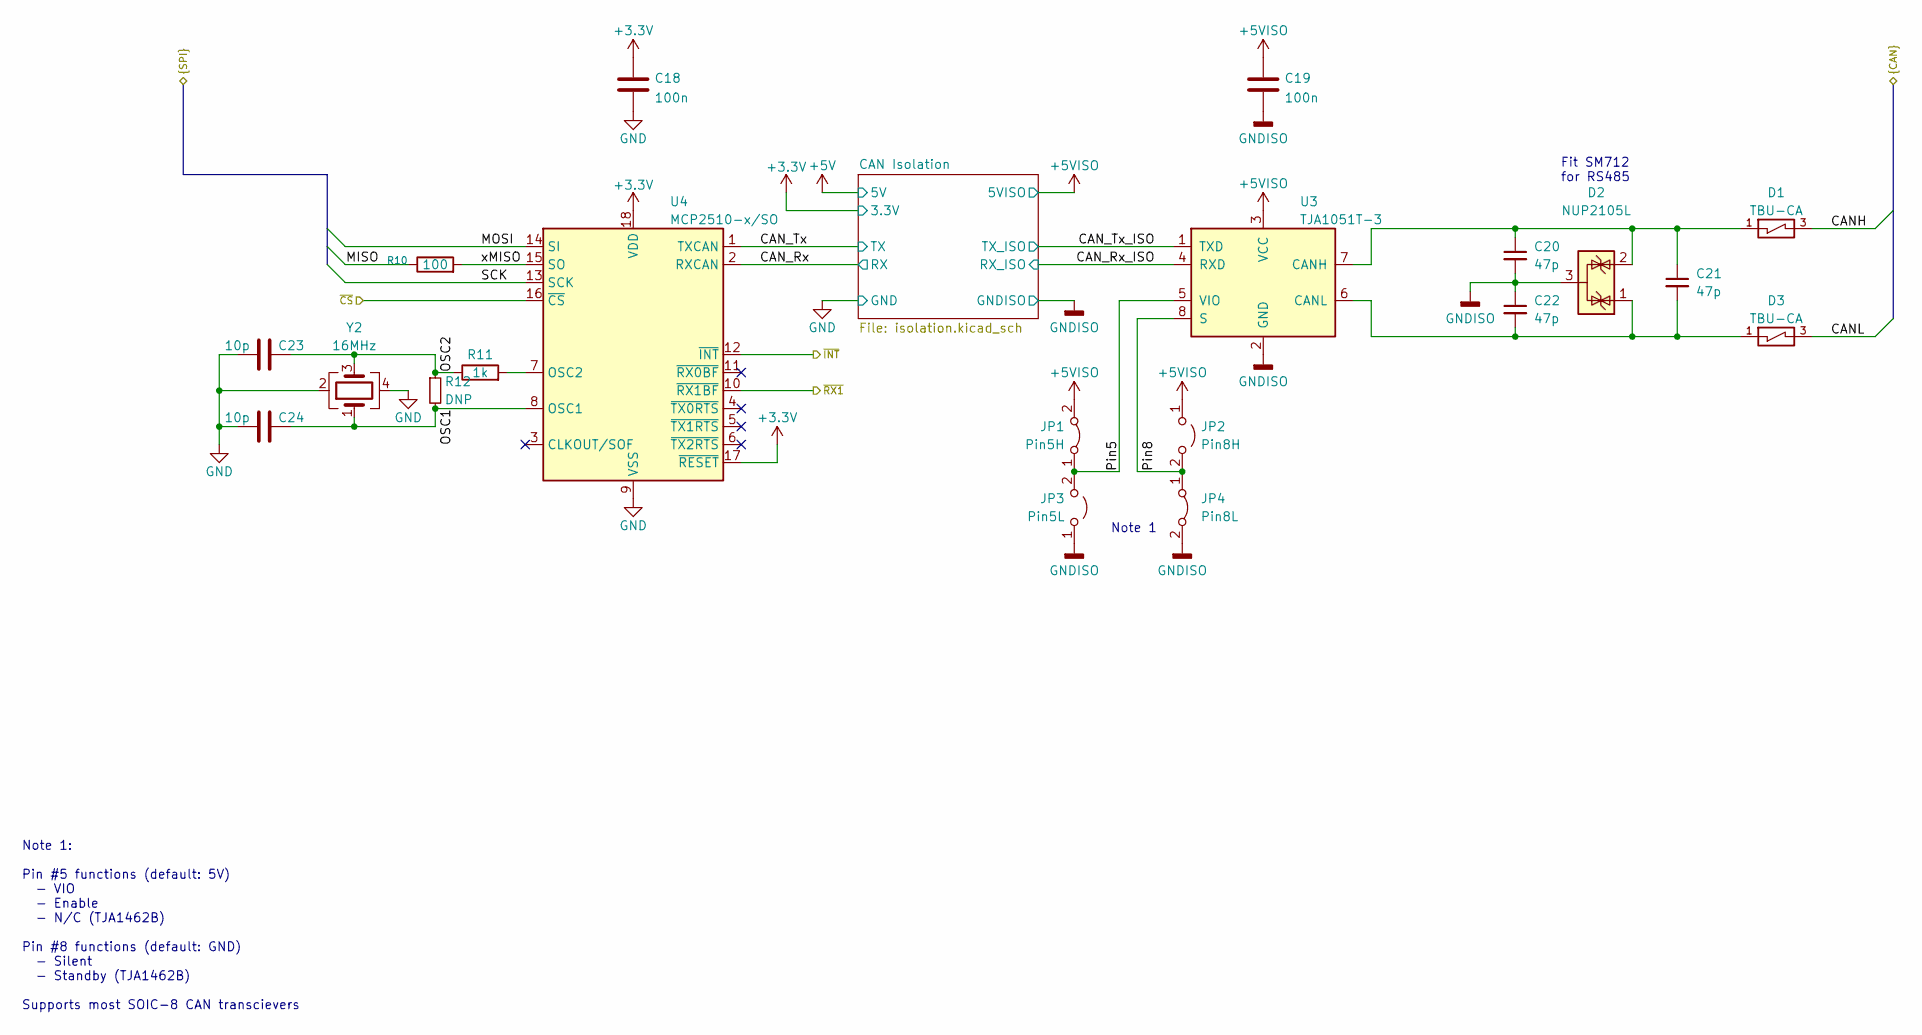
[picture p29: schematic can.kicad_sch, [canbrd] CAN IO board]

Parts:
C18, C19: 100n; C_0603_1608Metric
C20, C21, C22: 47p; C_0603_1608Metric
C23, C24: 10p; C_0603_1608Metric
D1, D3: TBU-CA; DIOC650X400X100N
D2: NUP2105L; SOT-23
JP1: Pin5H; SolderJumper-2_P1.3mm_Bridged_Pad1.0x1.5mm
JP2: Pin8H; SolderJumper-2_P1.3mm_Open_TrianglePad1.0x1.5mm
JP3: Pin5L; SolderJumper-2_P1.3mm_Open_TrianglePad1.0x1.5mm
JP4: Pin8L; SolderJumper-2_P1.3mm_Bridged_Pad1.0x1.5mm
R10: 100; R_0603_1608Metric
R11: 1k; R_0603_1608Metric
R12: DNP; R_0603_1608Metric
U3: TJA1051T-3; SOIC-8_3.9x4.9mm_P1.27mm
U4: MCP2510-x/SO; SOIC-18W_7.5x11.6mm_P1.27mm
Y2: 16MHz; Crystal_SMD_3225-4Pin_3.2x2.5mm

Connections:
+3V3: C18.1, U4.17 (~RESET), U4.18 (VDD); also elsewhere on the board
+5VISO: C19.1, JP1.2 (B), JP2.1 (A), U3.3 (VCC); also elsewhere on the board
/CAN/CANH: D1.3; also elsewhere on the board
/CAN/CANL: D3.3; also elsewhere on the board
/CAN/CAN_Rx: U4.2 (RXCAN); also elsewhere on the board
/CAN/CAN_Rx_ISO: U3.4 (RXD); also elsewhere on the board
/CAN/CAN_Tx: U4.1 (TXCAN); also elsewhere on the board
/CAN/CAN_Tx_ISO: U3.1 (TXD); also elsewhere on the board
/CAN/MISO: R10.1; also elsewhere on the board
/CAN/MOSI: U4.14 (SI); also elsewhere on the board
/CAN/OSC1: C24.2, R12.2, U4.8 (OSC1), Y2.1
/CAN/OSC2: C23.2, R11.1, R12.1, Y2.3
/CAN/Pin5: JP1.1 (A), JP3.2 (B), U3.5 (VIO)
/CAN/Pin8: JP2.2 (B), JP4.1 (A), U3.8 (S)
/CAN/SCK: U4.13 (SCK); also elsewhere on the board
/CAN/xMISO: R10.2, U4.15 (SO)
/CAN/~CS: U4.16 (~CS); also elsewhere on the board
/CAN/~INT: U4.12 (~INT); also elsewhere on the board
/CAN/~RX1: U4.10 (~RX1BF); also elsewhere on the board
GND: C18.2, C23.1, C24.1, U4.9 (VSS), Y2.2, Y2.4; also elsewhere on the board
GNDISO: C19.2, C20.2, C22.1, D2.3 (A), JP3.1 (A), JP4.2 (B), U3.2 (GND); also elsewhere on the board
unnamed: C20.1, C21.1, D1.1, D2.2 (K), U3.7 (CANH)
unnamed: C21.2, C22.2, D2.1 (K), D3.1, U3.6 (CANL)
unnamed: R11.2, U4.7 (OSC2)

Notes on the sheet:
Note 1: Pin #5 functions (default: 5V) - VIO - Enable - N/C (TJA1462B) Pin #8 functions (default: GND) - Silent - Standby (TJA1462B) Supports most SOIC-8 CAN transcievers
Note 1
Fit SM712 for RS485

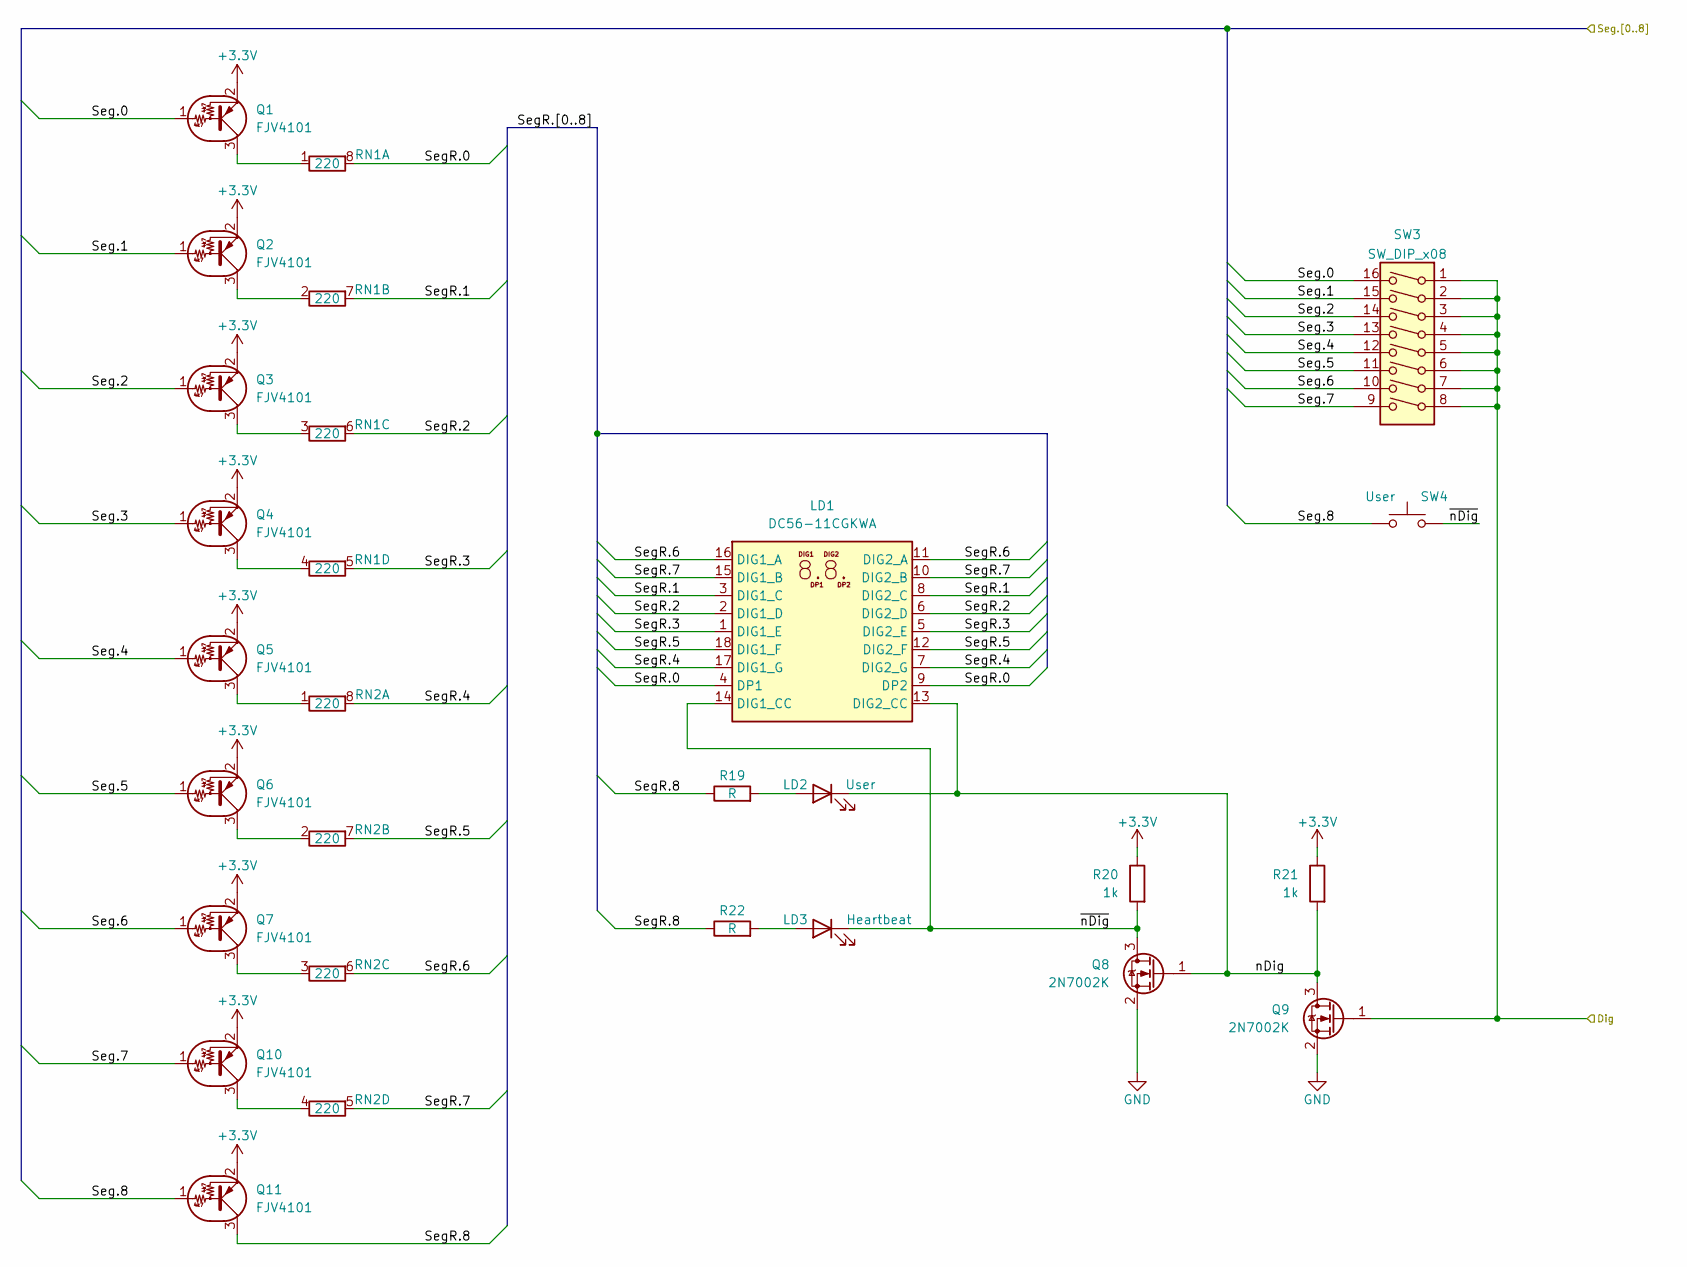
[picture p30: schematic onboard.kicad_sch, [canbrd] CAN IO board]

Parts:
LD1: DC56-11CGKWA; LB-402
LD2: User; LED_0805_2012Metric
LD3: Heartbeat; LED_0805_2012Metric
Q1, Q2, Q3, Q4, Q5, Q6, Q7, Q10, Q11: FJV4101; SOT-23
Q8, Q9: 2N7002K; SOT-23
R19, R22: R; R_0603_1608Metric
R20, R21: 1k; R_0603_1608Metric
RN1, RN2: 220; R_Array_Convex_4x0603
SW3: SW_DIP_x08; SW_DIP_SPSTx08_Slide_KingTek_DSHP08TS_W7.62mm_P1.27mm
SW4: User; PTS815-SJ

Connections:
+3V3: Q1.2 (E), Q2.2 (E), Q3.2 (E), Q4.2 (E), Q5.2 (E), Q6.2 (E), Q7.2 (E), Q10.2 (E), Q11.2 (E), R20.1, R21.1; also elsewhere on the board
/DISP+SW/Dig: Q9.1 (G), SW3.1, SW3.2, SW3.3, SW3.4, SW3.5, SW3.6, SW3.7, SW3.8; also elsewhere on the board
/DISP+SW/Seg.0: Q1.1 (B), SW3.16; also elsewhere on the board
/DISP+SW/Seg.1: Q2.1 (B), SW3.15; also elsewhere on the board
/DISP+SW/Seg.2: Q3.1 (B), SW3.14; also elsewhere on the board
/DISP+SW/Seg.3: Q4.1 (B), SW3.13; also elsewhere on the board
/DISP+SW/Seg.4: Q5.1 (B), SW3.12; also elsewhere on the board
/DISP+SW/Seg.5: Q6.1 (B), SW3.11; also elsewhere on the board
/DISP+SW/Seg.6: Q7.1 (B), SW3.10; also elsewhere on the board
/DISP+SW/Seg.7: Q10.1 (B), SW3.9; also elsewhere on the board
/DISP+SW/Seg.8: Q11.1 (B), SW4.2; also elsewhere on the board
/DISP+SW/SegR.0: LD1.4 (DP1), LD1.9 (DP2), RN1.8 (R1.2)
/DISP+SW/SegR.1: LD1.3 (DIG1_C), LD1.8 (DIG2_C), RN1.7 (R2.2)
/DISP+SW/SegR.2: LD1.2 (DIG1_D), LD1.6 (DIG2_D), RN1.6 (R3.2)
/DISP+SW/SegR.3: LD1.1 (DIG1_E), LD1.5 (DIG2_E), RN1.5 (R4.2)
/DISP+SW/SegR.4: LD1.7 (DIG2_G), LD1.17 (DIG1_G), RN2.8 (R1.2)
/DISP+SW/SegR.5: LD1.12 (DIG2_F), LD1.18 (DIG1_F), RN2.7 (R2.2)
/DISP+SW/SegR.6: LD1.11 (DIG2_A), LD1.16 (DIG1_A), RN2.6 (R3.2)
/DISP+SW/SegR.7: LD1.10 (DIG2_B), LD1.15 (DIG1_B), RN2.5 (R4.2)
/DISP+SW/SegR.8: Q11.3 (C), R19.1, R22.1
/DISP+SW/nDig: LD1.13 (DIG2_CC), LD2.1 (K), Q8.1 (G), Q9.3 (D), R21.2
/DISP+SW/~nDig: LD1.14 (DIG1_CC), LD3.1 (K), Q8.3 (D), R20.2, SW4.1
GND: Q8.2 (S), Q9.2 (S); also elsewhere on the board
unnamed: LD2.2 (A), R19.2
unnamed: LD3.2 (A), R22.2
unnamed: Q1.3 (C), RN1.1 (R1.1)
unnamed: Q2.3 (C), RN1.2 (R2.1)
unnamed: Q3.3 (C), RN1.3 (R3.1)
unnamed: Q4.3 (C), RN1.4 (R4.1)
unnamed: Q5.3 (C), RN2.1 (R1.1)
unnamed: Q6.3 (C), RN2.2 (R2.1)
unnamed: Q7.3 (C), RN2.3 (R3.1)
unnamed: Q10.3 (C), RN2.4 (R4.1)

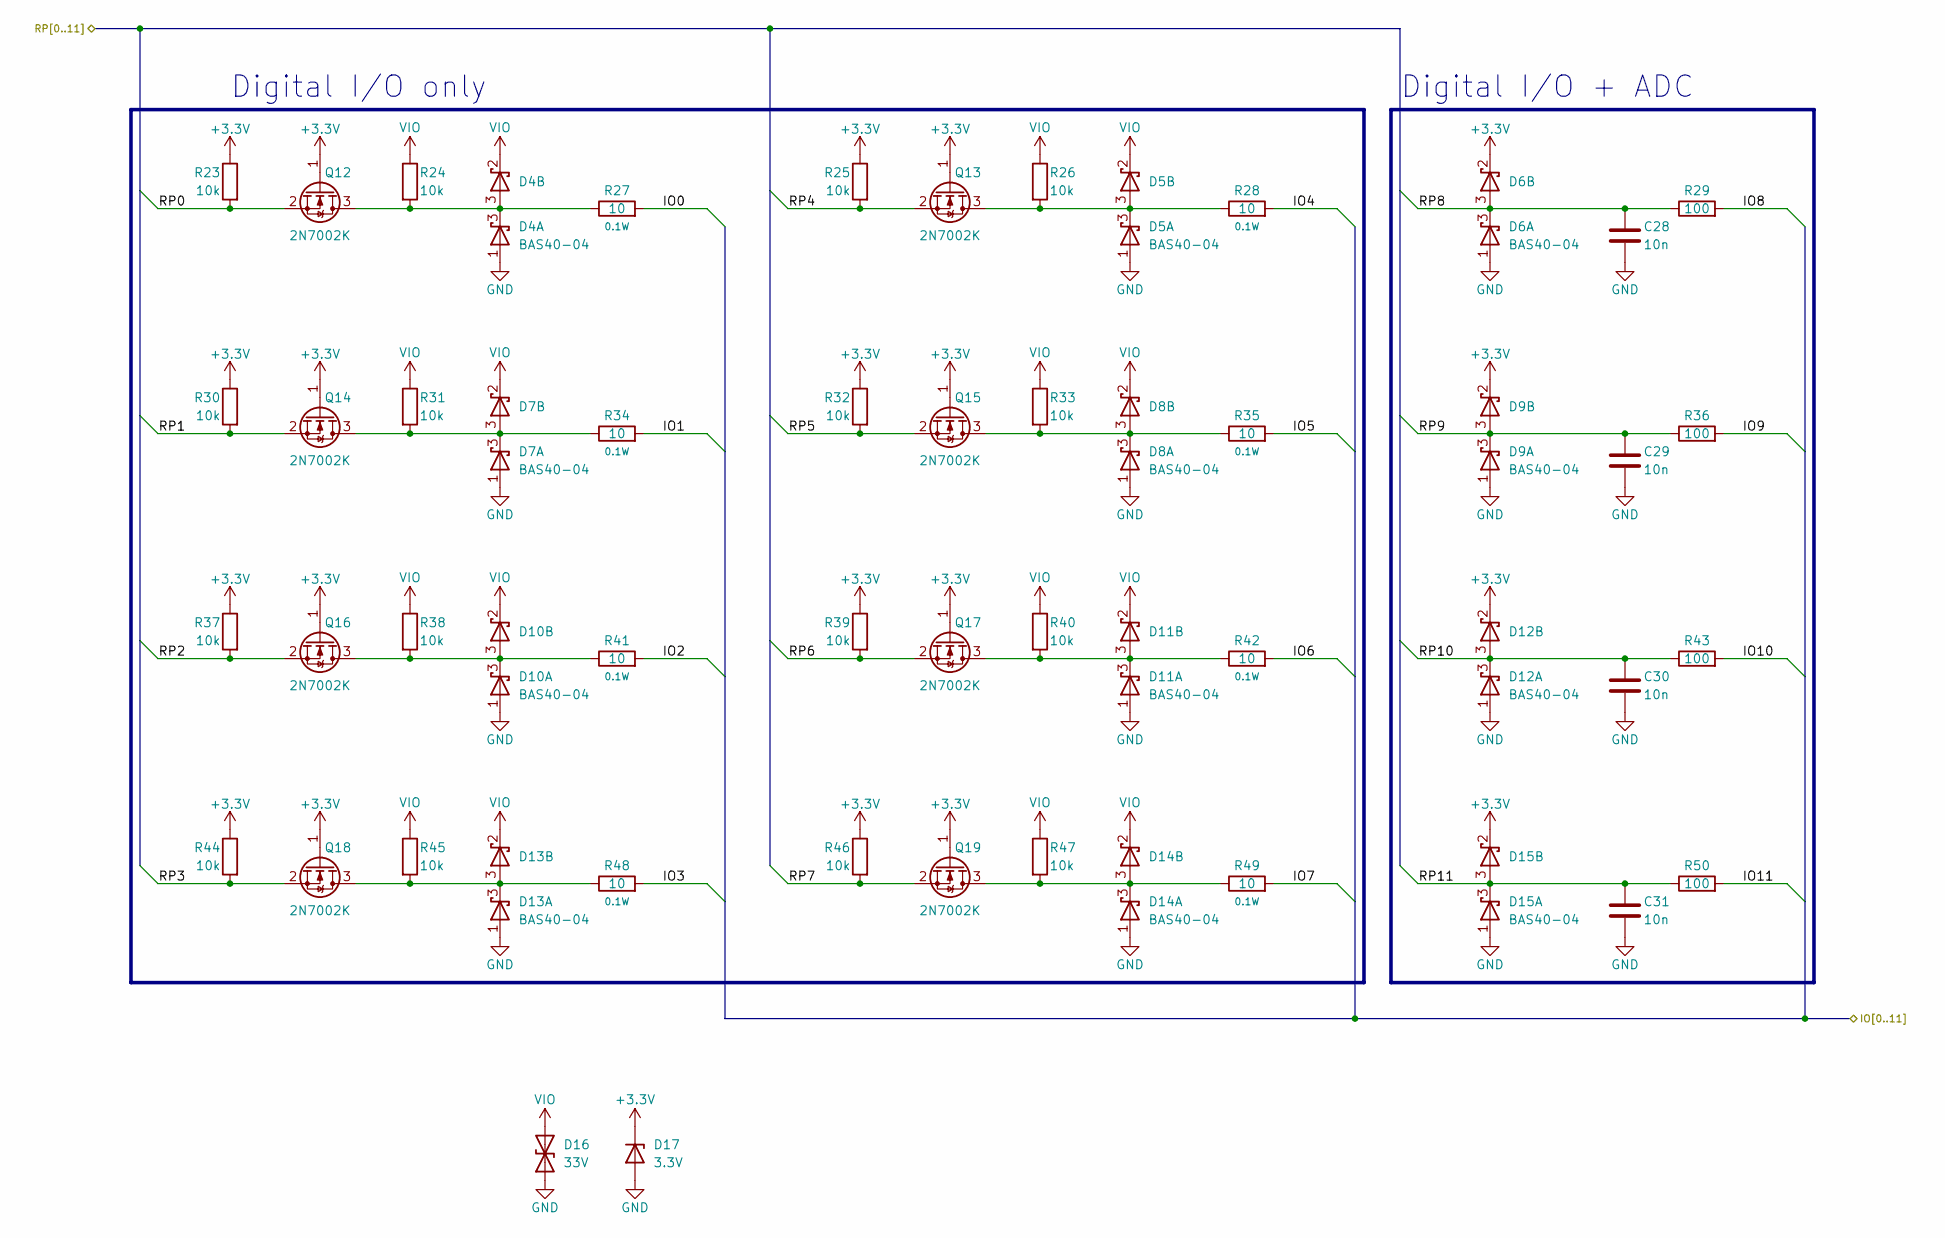
[picture p31: schematic io.kicad_sch, [canbrd] CAN IO board]

Parts:
C28, C29, C30, C31: 10n; C_0603_1608Metric
D4, D5, D6, D7, D8, D9, D10, D11, D12, D13, D14, D15: BAS40-04; SOT-23
D16: 33V; D_SMB
D17: 3.3V; D_MiniMELF
Q12, Q13, Q14, Q15, Q16, Q17, Q18, Q19: 2N7002K; SOT-23
R23, R24, R25, R26, R30, R31, R32, R33, R37, R38, R39, R40, R44, R45, R46, R47: 10k; R_0603_1608Metric
R27, R28, R34, R35, R41, R42, R48, R49: 10; R_0603_1608Metric
R29, R36, R43, R50: 100; R_0603_1608Metric

Connections:
+3V3: D6.2 (K), D9.2 (K), D12.2 (K), D15.2 (K), D17.1 (K), Q12.1 (G), Q13.1 (G), Q14.1 (G), Q15.1 (G), Q16.1 (G), Q17.1 (G), Q18.1 (G), Q19.1 (G), R23.1, R25.1, R30.1, R32.1, R37.1, R39.1, R44.1, R46.1; also elsewhere on the board
/Connectors/IO0: R27.2; also elsewhere on the board
/Connectors/IO1: R34.2; also elsewhere on the board
/Connectors/IO2: R41.2; also elsewhere on the board
/Connectors/IO3: R48.2; also elsewhere on the board
/Connectors/IO4: R28.2; also elsewhere on the board
/Connectors/IO5: R35.2; also elsewhere on the board
/Connectors/IO6: R42.2; also elsewhere on the board
/Connectors/IO7: R49.2; also elsewhere on the board
/Connectors/IO8: R29.2; also elsewhere on the board
/Connectors/IO9: R36.2; also elsewhere on the board
/Connectors/IO10: R43.2; also elsewhere on the board
/Connectors/IO11: R50.2; also elsewhere on the board
/IO/RP0: Q12.2 (S), R23.2; also elsewhere on the board
/IO/RP1: Q14.2 (S), R30.2; also elsewhere on the board
/IO/RP2: Q16.2 (S), R37.2; also elsewhere on the board
/IO/RP3: Q18.2 (S), R44.2; also elsewhere on the board
/IO/RP4: Q13.2 (S), R25.2; also elsewhere on the board
/IO/RP5: Q15.2 (S), R32.2; also elsewhere on the board
/IO/RP6: Q17.2 (S), R39.2; also elsewhere on the board
/IO/RP7: Q19.2 (S), R46.2; also elsewhere on the board
/IO/RP8: C28.1, D6.3 (K), R29.1; also elsewhere on the board
/IO/RP9: C29.1, D9.3 (K), R36.1; also elsewhere on the board
/IO/RP10: C30.1, D12.3 (K), R43.1; also elsewhere on the board
/IO/RP11: C31.1, D15.3 (K), R50.1; also elsewhere on the board
GND: C28.2, C29.2, C30.2, C31.2, D4.1 (A), D5.1 (A), D6.1 (A), D7.1 (A), D8.1 (A), D9.1 (A), D10.1 (A), D11.1 (A), D12.1 (A), D13.1 (A), D14.1 (A), D15.1 (A), D16.1 (A1), D17.2 (A); also elsewhere on the board
unnamed: D4.3 (K), Q12.3 (D), R24.2, R27.1
unnamed: D5.3 (K), Q13.3 (D), R26.2, R28.1
unnamed: D7.3 (K), Q14.3 (D), R31.2, R34.1
unnamed: D8.3 (K), Q15.3 (D), R33.2, R35.1
unnamed: D10.3 (K), Q16.3 (D), R38.2, R41.1
unnamed: D11.3 (K), Q17.3 (D), R40.2, R42.1
unnamed: D13.3 (K), Q18.3 (D), R45.2, R48.1
unnamed: D14.3 (K), Q19.3 (D), R47.2, R49.1
VIO: D4.2 (K), D5.2 (K), D7.2 (K), D8.2 (K), D10.2 (K), D11.2 (K), D13.2 (K), D14.2 (K), D16.2 (A2), R24.1, R26.1, R31.1, R33.1, R38.1, R40.1, R45.1, R47.1; also elsewhere on the board

Notes on the sheet:
Digital I/O only
Digital I/O + ADC

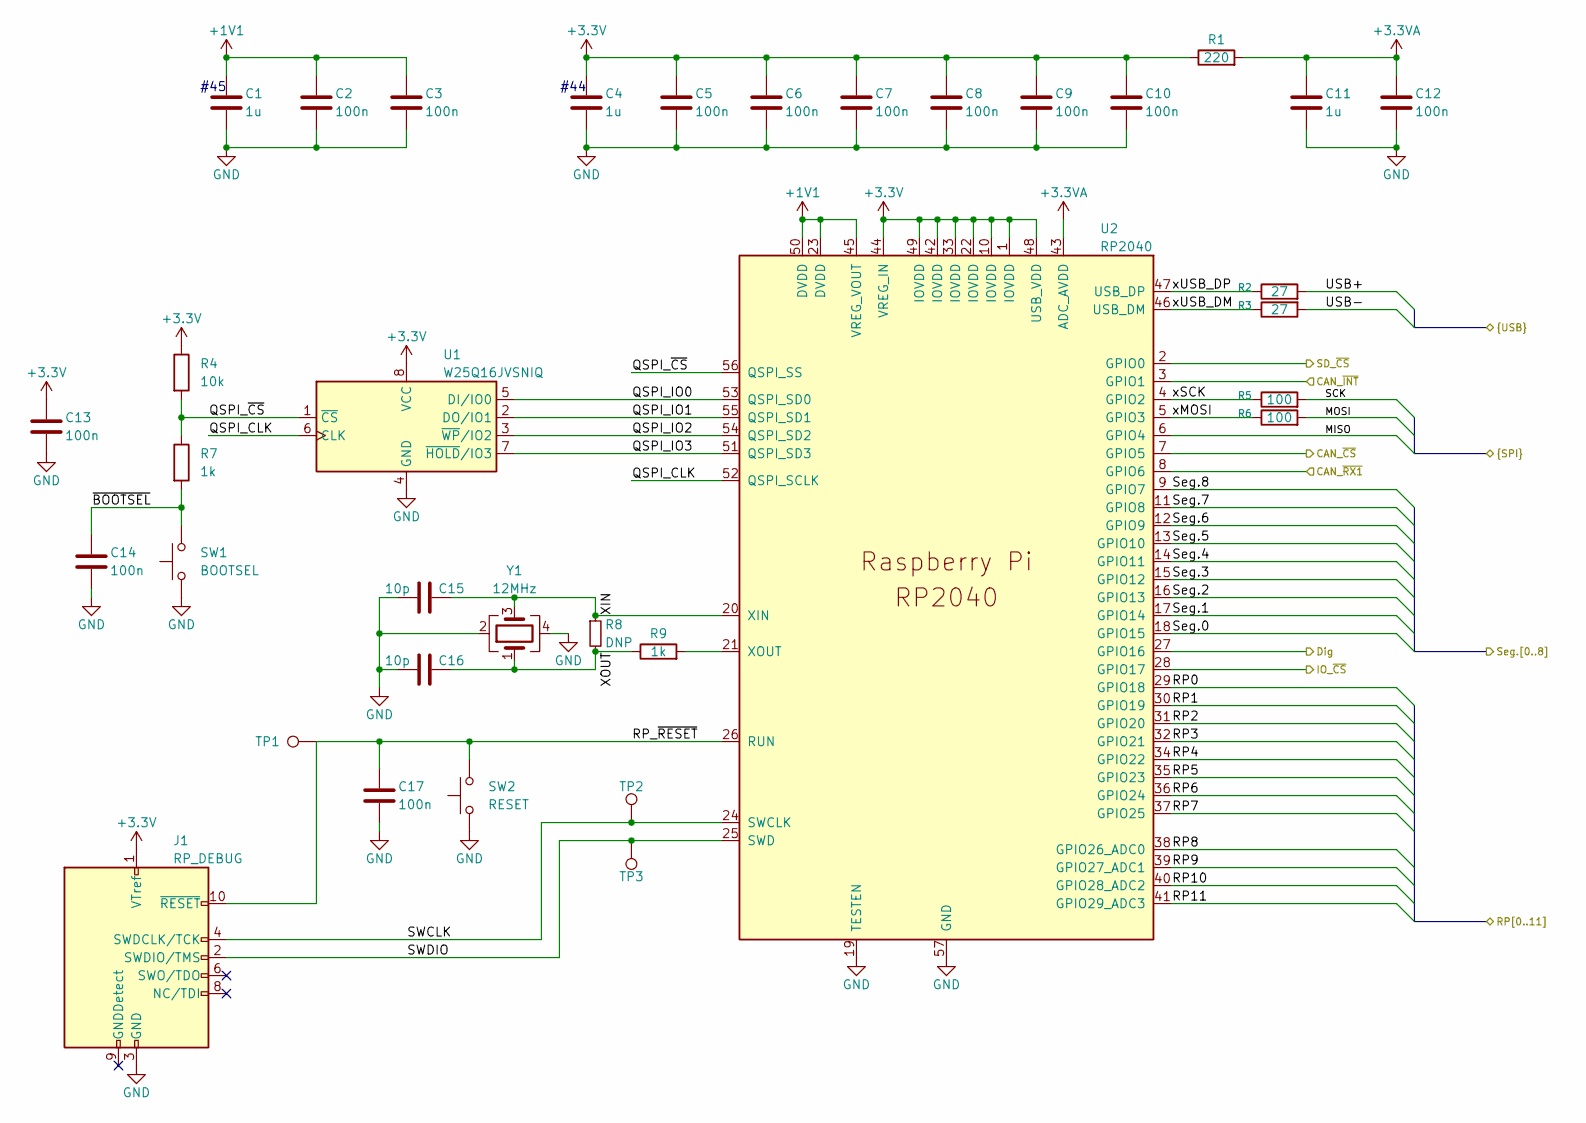
[picture p32: schematic mcu.kicad_sch, [canbrd] CAN IO board]

Parts:
C1, C4, C11: 1u; C_0603_1608Metric
C2, C3, C5, C6, C7, C8, C9, C10, C12, C13, C14, C17: 100n; C_0603_1608Metric
C15, C16: 10p; C_0603_1608Metric
J1: RP_DEBUG; PinHeader_2x05_P1.27mm_Vertical_SMD
R1: 220; R_0603_1608Metric
R2, R3: 27; R_0603_1608Metric
R4: 10k; R_0603_1608Metric
R5, R6: 100; R_0603_1608Metric
R7, R9: 1k; R_0603_1608Metric
R8: DNP; R_0603_1608Metric
SW1: BOOTSEL; PTS815-SJ
SW2: RESET; PTS815-SJ
TP1, TP2, TP3: TestPoint; TestPoint_THTPad_D2.0mm_Drill1.0mm
U1: W25Q16JVSNIQ; SOIC-8_3.9x4.9mm_P1.27mm
U2: RP2040; RP2040-QFN-56
Y1: 12MHz; Crystal_SMD_3225-4Pin_3.2x2.5mm

Connections:
+1V1: C1.1, C2.1, C3.1, U2.23 (DVDD), U2.45 (VREG_VOUT), U2.50 (DVDD)
+3.3VA: C11.1, C12.1, R1.2, U2.43 (ADC_AVDD)
+3V3: C4.1, C5.1, C6.1, C7.1, C8.1, C9.1, C10.1, C13.1, J1.1 (VTref), R1.1, R4.1, U1.8 (VCC), U2.1 (IOVDD), U2.10 (IOVDD), U2.22 (IOVDD), U2.33 (IOVDD), U2.42 (IOVDD), U2.44 (VREG_IN), U2.48 (USB_VDD), U2.49 (IOVDD); also elsewhere on the board
/CAN/MISO: U2.6 (GPIO4); also elsewhere on the board
/CAN/MOSI: R6.2; also elsewhere on the board
/CAN/SCK: R5.2; also elsewhere on the board
/CAN/~CS: U2.7 (GPIO5); also elsewhere on the board
/CAN/~INT: U2.3 (GPIO1); also elsewhere on the board
/CAN/~RX1: U2.8 (GPIO6); also elsewhere on the board
/Connectors/USB+: R2.2; also elsewhere on the board
/Connectors/USB-: R3.2; also elsewhere on the board
/DISP+SW/Dig: U2.27 (GPIO16); also elsewhere on the board
/DISP+SW/Seg.0: U2.18 (GPIO15); also elsewhere on the board
/DISP+SW/Seg.1: U2.17 (GPIO14); also elsewhere on the board
/DISP+SW/Seg.2: U2.16 (GPIO13); also elsewhere on the board
/DISP+SW/Seg.3: U2.15 (GPIO12); also elsewhere on the board
/DISP+SW/Seg.4: U2.14 (GPIO11); also elsewhere on the board
/DISP+SW/Seg.5: U2.13 (GPIO10); also elsewhere on the board
/DISP+SW/Seg.6: U2.12 (GPIO9); also elsewhere on the board
/DISP+SW/Seg.7: U2.11 (GPIO8); also elsewhere on the board
/DISP+SW/Seg.8: U2.9 (GPIO7); also elsewhere on the board
/IO Expander/595_~CS: U2.28 (GPIO17); also elsewhere on the board
/IO/RP0: U2.29 (GPIO18); also elsewhere on the board
/IO/RP1: U2.30 (GPIO19); also elsewhere on the board
/IO/RP2: U2.31 (GPIO20); also elsewhere on the board
/IO/RP3: U2.32 (GPIO21); also elsewhere on the board
/IO/RP4: U2.34 (GPIO22); also elsewhere on the board
/IO/RP5: U2.35 (GPIO23); also elsewhere on the board
/IO/RP6: U2.36 (GPIO24); also elsewhere on the board
/IO/RP7: U2.37 (GPIO25); also elsewhere on the board
/IO/RP8: U2.38 (GPIO26_ADC0); also elsewhere on the board
/IO/RP9: U2.39 (GPIO27_ADC1); also elsewhere on the board
/IO/RP10: U2.40 (GPIO28_ADC2); also elsewhere on the board
/IO/RP11: U2.41 (GPIO29_ADC3); also elsewhere on the board
/MCU/QSPI_CLK: U1.6 (CLK), U2.52 (QSPI_SCLK)
/MCU/QSPI_IO0: U1.5 (DI/IO0), U2.53 (QSPI_SD0)
/MCU/QSPI_IO1: U1.2 (DO/IO1), U2.55 (QSPI_SD1)
/MCU/QSPI_IO2: U1.3 (~WP/IO2), U2.54 (QSPI_SD2)
/MCU/QSPI_IO3: U1.7 (~HOLD/IO3), U2.51 (QSPI_SD3)
/MCU/QSPI_~CS: R4.2, R7.1, U1.1 (~CS), U2.56 (QSPI_SS)
/MCU/RP_~RESET: C17.1, J1.10 (~RESET), SW2.2, TP1.1, U2.26 (RUN)
/MCU/SD_~CS: U2.2 (GPIO0); also elsewhere on the board
/MCU/SWCLK: J1.4 (SWDCLK/TCK), TP2.1, U2.24 (SWCLK)
/MCU/SWDIO: J1.2 (SWDIO/TMS), TP3.1, U2.25 (SWD)
/MCU/XIN: C15.2, R8.1, U2.20 (XIN), Y1.3
/MCU/XOUT: C16.2, R8.2, R9.1, Y1.1
/MCU/xMOSI: R6.1, U2.5 (GPIO3)
/MCU/xSCK: R5.1, U2.4 (GPIO2)
/MCU/xUSB_DM: R3.1, U2.46 (USB_DM)
/MCU/xUSB_DP: R2.1, U2.47 (USB_DP)
/MCU/~BOOTSEL: C14.1, R7.2, SW1.1
GND: C1.2, C2.2, C3.2, C4.2, C5.2, C6.2, C7.2, C8.2, C9.2, C10.2, C11.2, C12.2, C13.2, C14.2, C15.1, C16.1, C17.2, J1.3 (GND), J1.5 (GND), SW1.2, SW2.1, U1.4 (GND), U2.19 (TESTEN), U2.57 (GND), Y1.2, Y1.4; also elsewhere on the board
unnamed: R9.2, U2.21 (XOUT)

Notes on the sheet:
#45
#44
