BME-SBT/canbrd_hardware/canbrd.kicad_pcb

## KiCad design canbrd.kicad_pcb (continued)

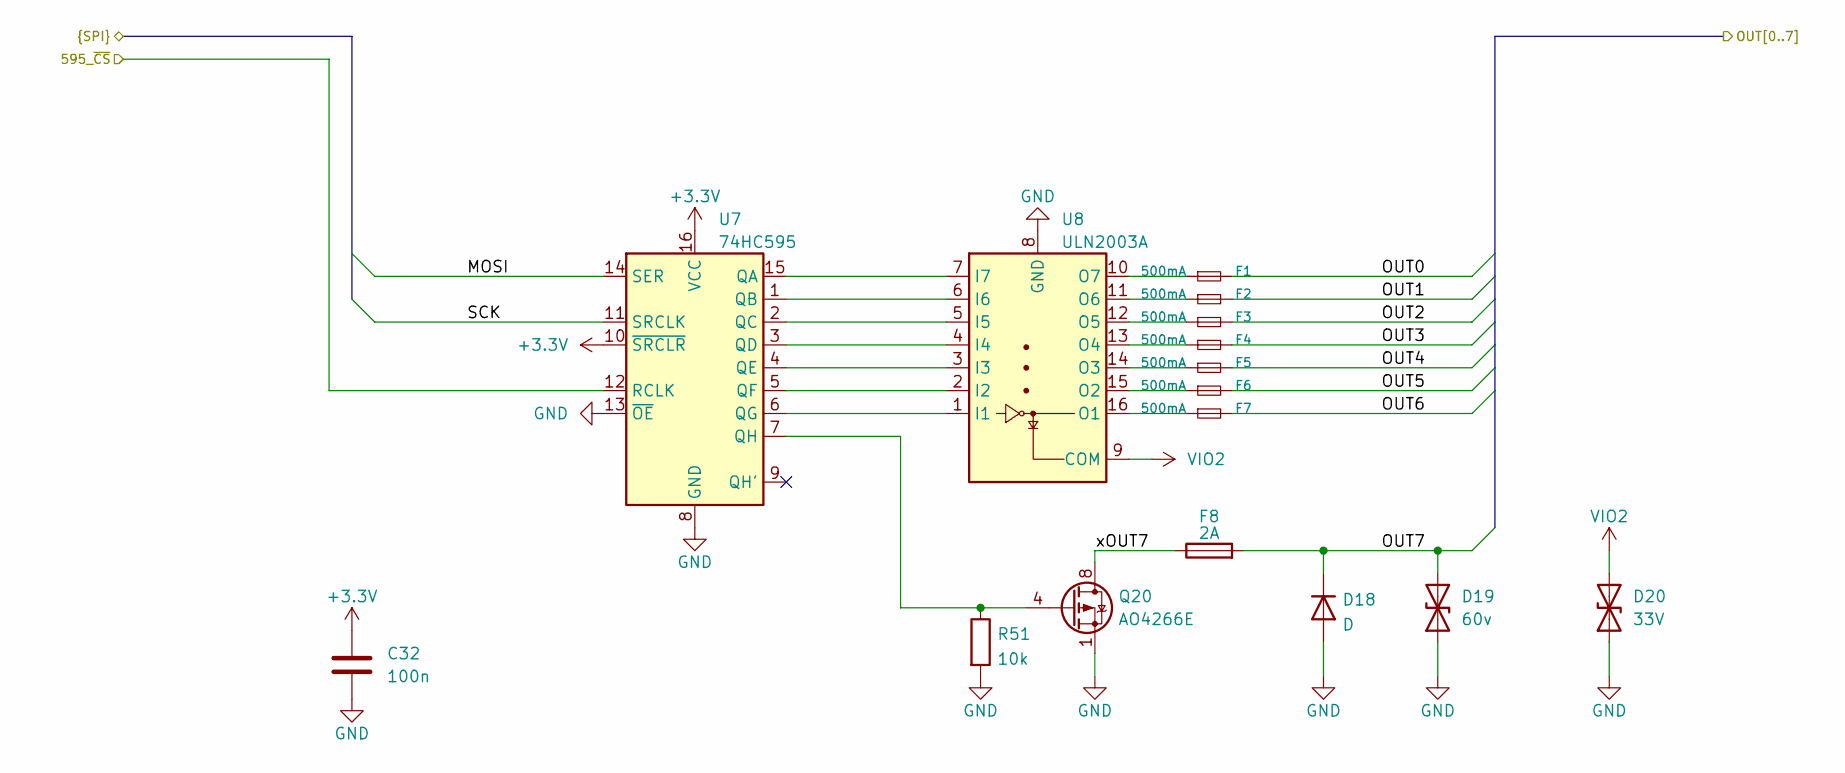
[picture p33: schematic io_expander.kicad_sch, [canbrd] CAN IO board]

Parts:
C32: 100n; C_0603_1608Metric
D18: D; D_SMB
D19: 60v; D_SMB
D20: 33V; D_SMB
F1, F2, F3, F4, F5, F6, F7: 500mA; Fuse_1206_3216Metric
F8: 2A; Littelfuse-154-2920
Q20: AO4266E; SOIC-8_3.9x4.9mm_P1.27mm
R51: 10k; R_0603_1608Metric
U7: 74HC595; SOIC-16_3.9x9.9mm_P1.27mm
U8: ULN2003A; SOIC-16_3.9x9.9mm_P1.27mm

Connections:
+3V3: C32.1, U7.10 (~SRCLR), U7.16 (VCC); also elsewhere on the board
/CAN/MOSI: U7.14 (SER); also elsewhere on the board
/CAN/SCK: U7.11 (SRCLK); also elsewhere on the board
/Connectors/OUT0: F1.2; also elsewhere on the board
/Connectors/OUT1: F2.2; also elsewhere on the board
/Connectors/OUT2: F3.2; also elsewhere on the board
/Connectors/OUT3: F4.2; also elsewhere on the board
/Connectors/OUT4: F5.2; also elsewhere on the board
/Connectors/OUT5: F6.2; also elsewhere on the board
/Connectors/OUT6: F7.2; also elsewhere on the board
/Connectors/OUT7: D18.1 (K), D19.2 (A2), F8.2; also elsewhere on the board
/IO Expander/595_~CS: U7.12 (RCLK); also elsewhere on the board
/IO Expander/xOUT7: F8.1, Q20.5 (D), Q20.6 (D), Q20.7 (D), Q20.8 (D)
GND: C32.2, D18.2 (A), D19.1 (A1), D20.1 (A1), Q20.1 (S), Q20.2 (S), Q20.3 (S), R51.2, U7.8 (GND), U7.13 (~OE), U8.8 (GND); also elsewhere on the board
unnamed: F1.1, U8.10 (O7)
unnamed: F2.1, U8.11 (O6)
unnamed: F3.1, U8.12 (O5)
unnamed: F4.1, U8.13 (O4)
unnamed: F5.1, U8.14 (O3)
unnamed: F6.1, U8.15 (O2)
unnamed: F7.1, U8.16 (O1)
unnamed: Q20.4 (G), R51.1, U7.7 (QH)
unnamed: U7.1 (QB), U8.6 (I6)
unnamed: U7.2 (QC), U8.5 (I5)
unnamed: U7.3 (QD), U8.4 (I4)
unnamed: U7.4 (QE), U8.3 (I3)
unnamed: U7.5 (QF), U8.2 (I2)
unnamed: U7.6 (QG), U8.1 (I1)
unnamed: U7.15 (QA), U8.7 (I7)
VIO2: D20.2 (A2), U8.9 (COM); also elsewhere on the board

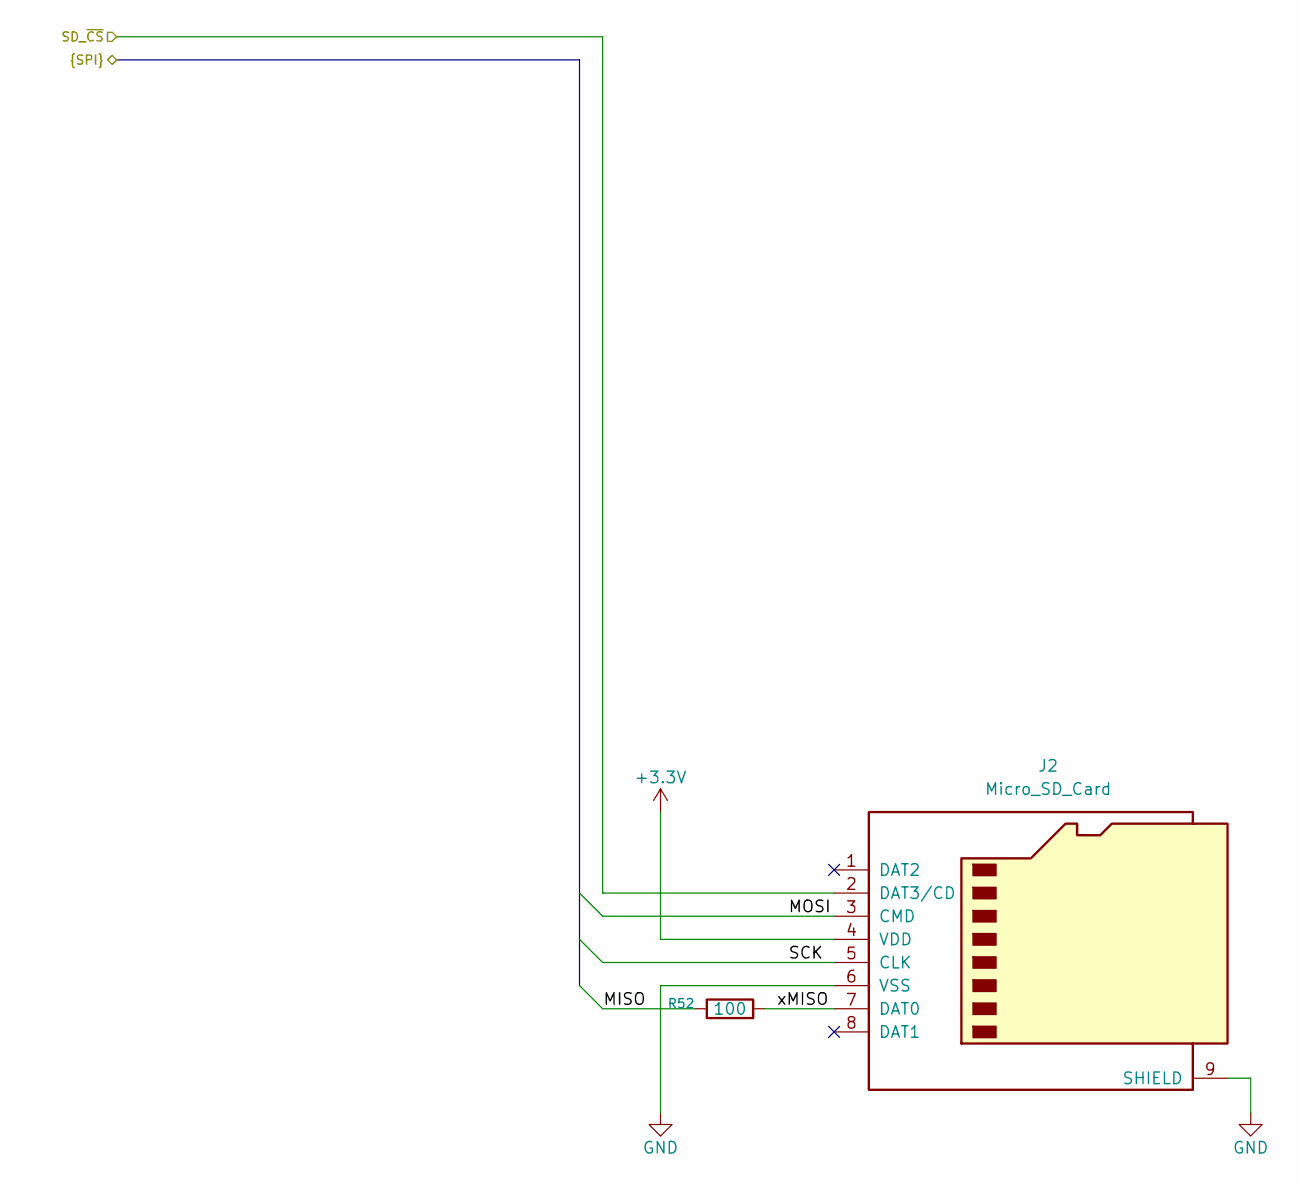
[picture p34: schematic memory.kicad_sch, [canbrd] CAN IO board]

Parts:
J2: Micro_SD_Card; GTFH081x1YHR
R52: 100; R_0603_1608Metric

Connections:
+3V3: J2.4 (VDD); also elsewhere on the board
/CAN/MISO: R52.1; also elsewhere on the board
/CAN/MOSI: J2.3 (CMD); also elsewhere on the board
/CAN/SCK: J2.5 (CLK); also elsewhere on the board
/MCU/SD_~CS: J2.2 (DAT3/CD); also elsewhere on the board
/SD/xMISO: J2.7 (DAT0), R52.2
GND: J2.6 (VSS), J2.9 (SHIELD); also elsewhere on the board

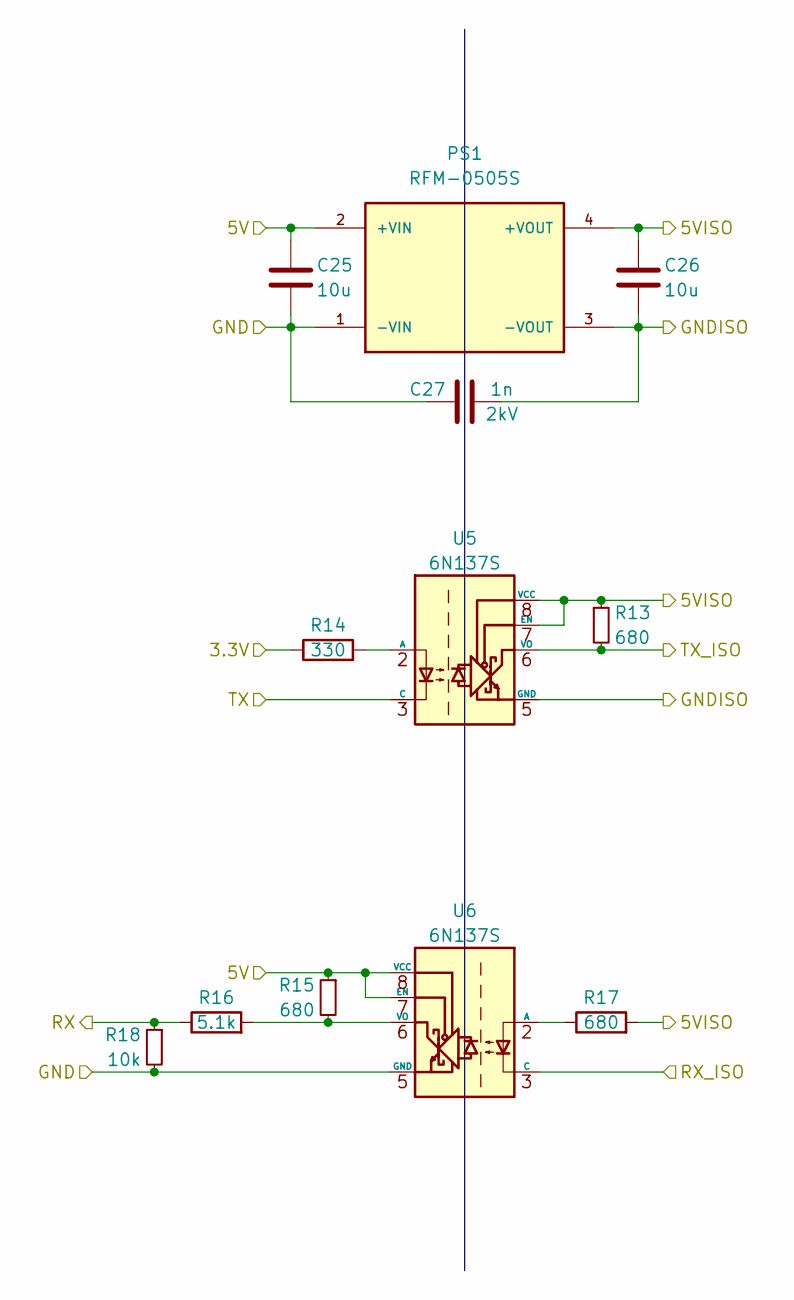
[picture p35: schematic isolation.kicad_sch, [canbrd] CAN IO board]

Parts:
C25, C26: 10u; C_0805_2012Metric
C27: 1n; C_1206_3216Metric_Pad1.33x1.80mm_HandSolder; Voltage 2kV
PS1: RFM-0505S; CONV_RFM-0505S
R13, R15, R17: 680; R_0603_1608Metric
R14: 330; R_0603_1608Metric
R16: 5.1k; R_0603_1608Metric
R18: 10k; R_0603_1608Metric
U5, U6: 6N137S; SMDIP-8_W9.53mm

Connections:
+3V3: R14.1; also elsewhere on the board
+5V: C25.1, PS1.2 (+VIN), R15.1, U6.7 (EN), U6.8 (VCC); also elsewhere on the board
+5VISO: C26.1, PS1.4 (+VOUT), R13.1, R17.2, U5.7 (EN), U5.8 (VCC); also elsewhere on the board
/CAN/CAN_Rx: R16.1, R18.1; also elsewhere on the board
/CAN/CAN_Rx_ISO: U6.3 (C); also elsewhere on the board
/CAN/CAN_Tx: U5.3 (C); also elsewhere on the board
/CAN/CAN_Tx_ISO: R13.2, U5.6 (VO); also elsewhere on the board
GND: C25.2, C27.1, PS1.1 (-VIN), R18.2, U6.5 (GND); also elsewhere on the board
GNDISO: C26.2, C27.2, PS1.3 (-VOUT), U5.5 (GND); also elsewhere on the board
unnamed: R14.2, U5.2 (A)
unnamed: R15.2, R16.2, U6.6 (VO)
unnamed: R17.1, U6.2 (A)

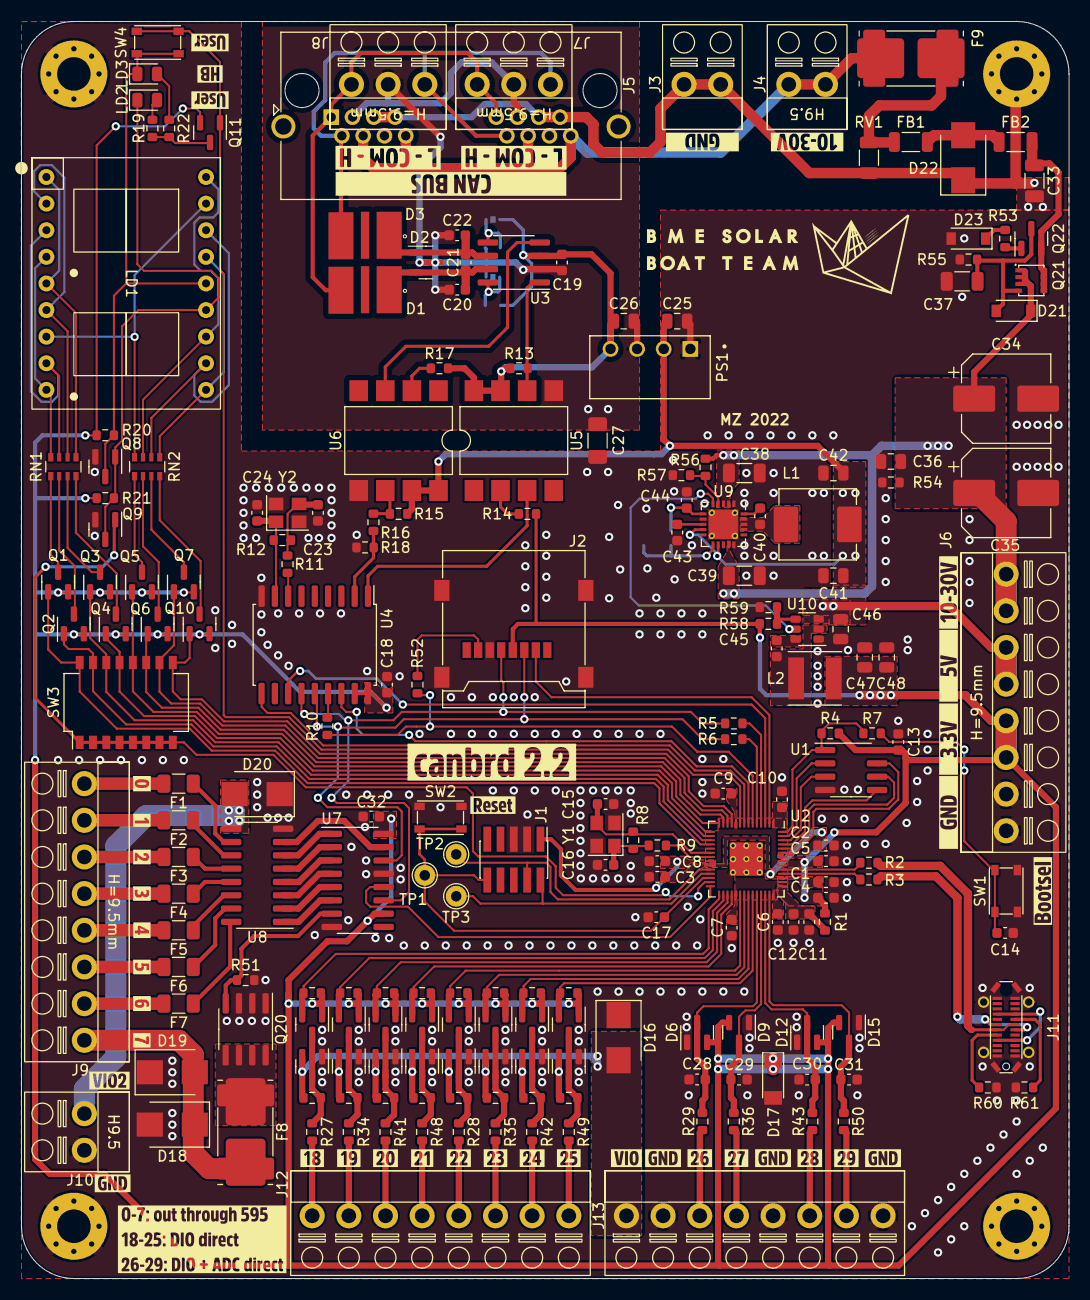
[picture p36: board canbrd.kicad_pcb from above]

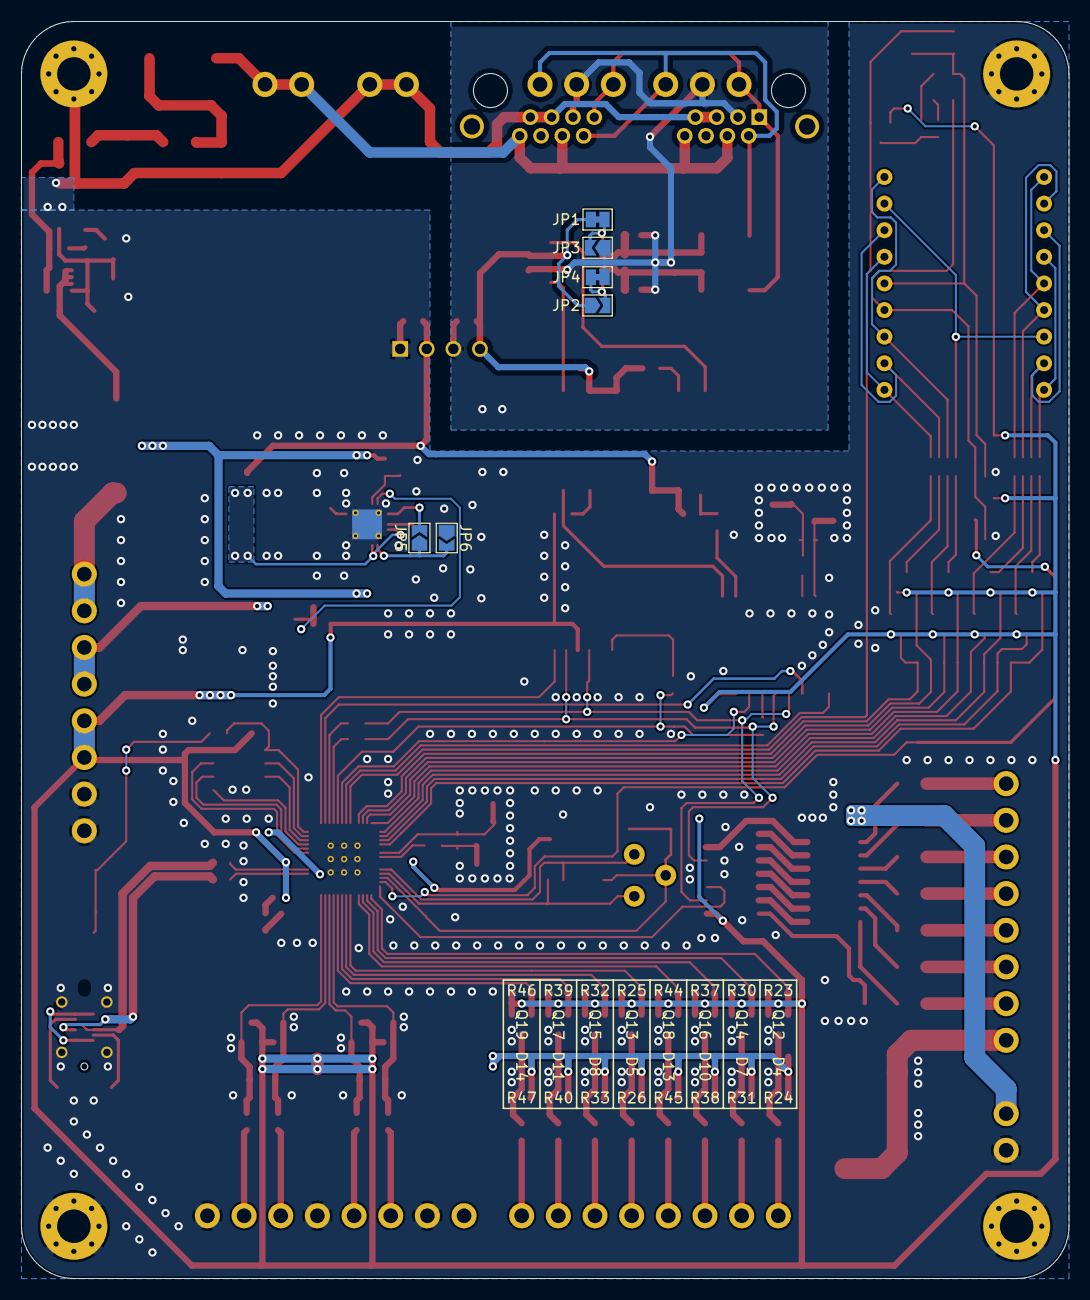
[picture p37: board canbrd.kicad_pcb from below]

Board: 2 copper layers, 100.0 x 120.0 mm, 258 parts (6 on the bottom side), 162 nets.

Other parts of the board:
kibuzzard-624B71BB: G***; kibuzzard-624B71BB
kibuzzard-624B71D2: G***; kibuzzard-624B71D2
kibuzzard-624B71E6: G***; kibuzzard-624B71E6
kibuzzard-624B71F2: G***; kibuzzard-624B71F2
kibuzzard-624B71FA: G***; kibuzzard-624B71FA
kibuzzard-624B75E6: G***; kibuzzard-624B75E6
kibuzzard-624B75EF: G***; kibuzzard-624B75EF
kibuzzard-624B75FB: G***; kibuzzard-624B75FB
kibuzzard-624B720A: G***; kibuzzard-624B720A
kibuzzard-624B724B: G***; kibuzzard-624B724B
kibuzzard-624B766D: G***; kibuzzard-624B766D
kibuzzard-624B7201: G***; kibuzzard-624B7201
kibuzzard-624B7210: G***; kibuzzard-624B7210
kibuzzard-624B7220: G***; kibuzzard-624B7220
kibuzzard-624B7229: G***; kibuzzard-624B7229
kibuzzard-624B7230: G***; kibuzzard-624B7230
kibuzzard-624B7237: G***; kibuzzard-624B7237
kibuzzard-624B7242: G***; kibuzzard-624B7242
kibuzzard-624B7247: G***; kibuzzard-624B7247
kibuzzard-624B7255: G***; kibuzzard-624B7255
kibuzzard-624B7539: G***; kibuzzard-624B7539
kibuzzard-624B7544: G***; kibuzzard-624B7544
kibuzzard-624B7558: G***; kibuzzard-624B7558
kibuzzard-624B7567: G***; kibuzzard-624B7567
kibuzzard-624B7585: G***; kibuzzard-624B7585
kibuzzard-62179C5E: G***; kibuzzard-62179C5E
kibuzzard-62179C9D: G***; kibuzzard-62179C9D
kibuzzard-62179CFC: G***; kibuzzard-62179CFC
kibuzzard-62179D4A: G***; kibuzzard-62179D4A
kibuzzard-62179F21: G***; kibuzzard-62179F21
kibuzzard-62991FA5, kibuzzard-62991FA5#2: G***; kibuzzard-62991FA5
kibuzzard-629153AB: G***; kibuzzard-629153AB
kibuzzard-629155A8: G***; kibuzzard-629155A8
kibuzzard-629155F9: G***; kibuzzard-629155F9
kibuzzard-629930A8: G***; kibuzzard-629930A8
kibuzzard-629930D0, kibuzzard-629930D0#2: G***; kibuzzard-629930D0
kibuzzard-62915456: G***; kibuzzard-62915456
kibuzzard-62915475: G***; kibuzzard-62915475
kibuzzard-62915589: G***; kibuzzard-62915589
kibuzzard-62992008: G***; kibuzzard-62992008
