BME-SBT/canbrd_hardware/hardware.kicad_pcb

## KiCad design hardware.kicad_pcb (2022-03-07)

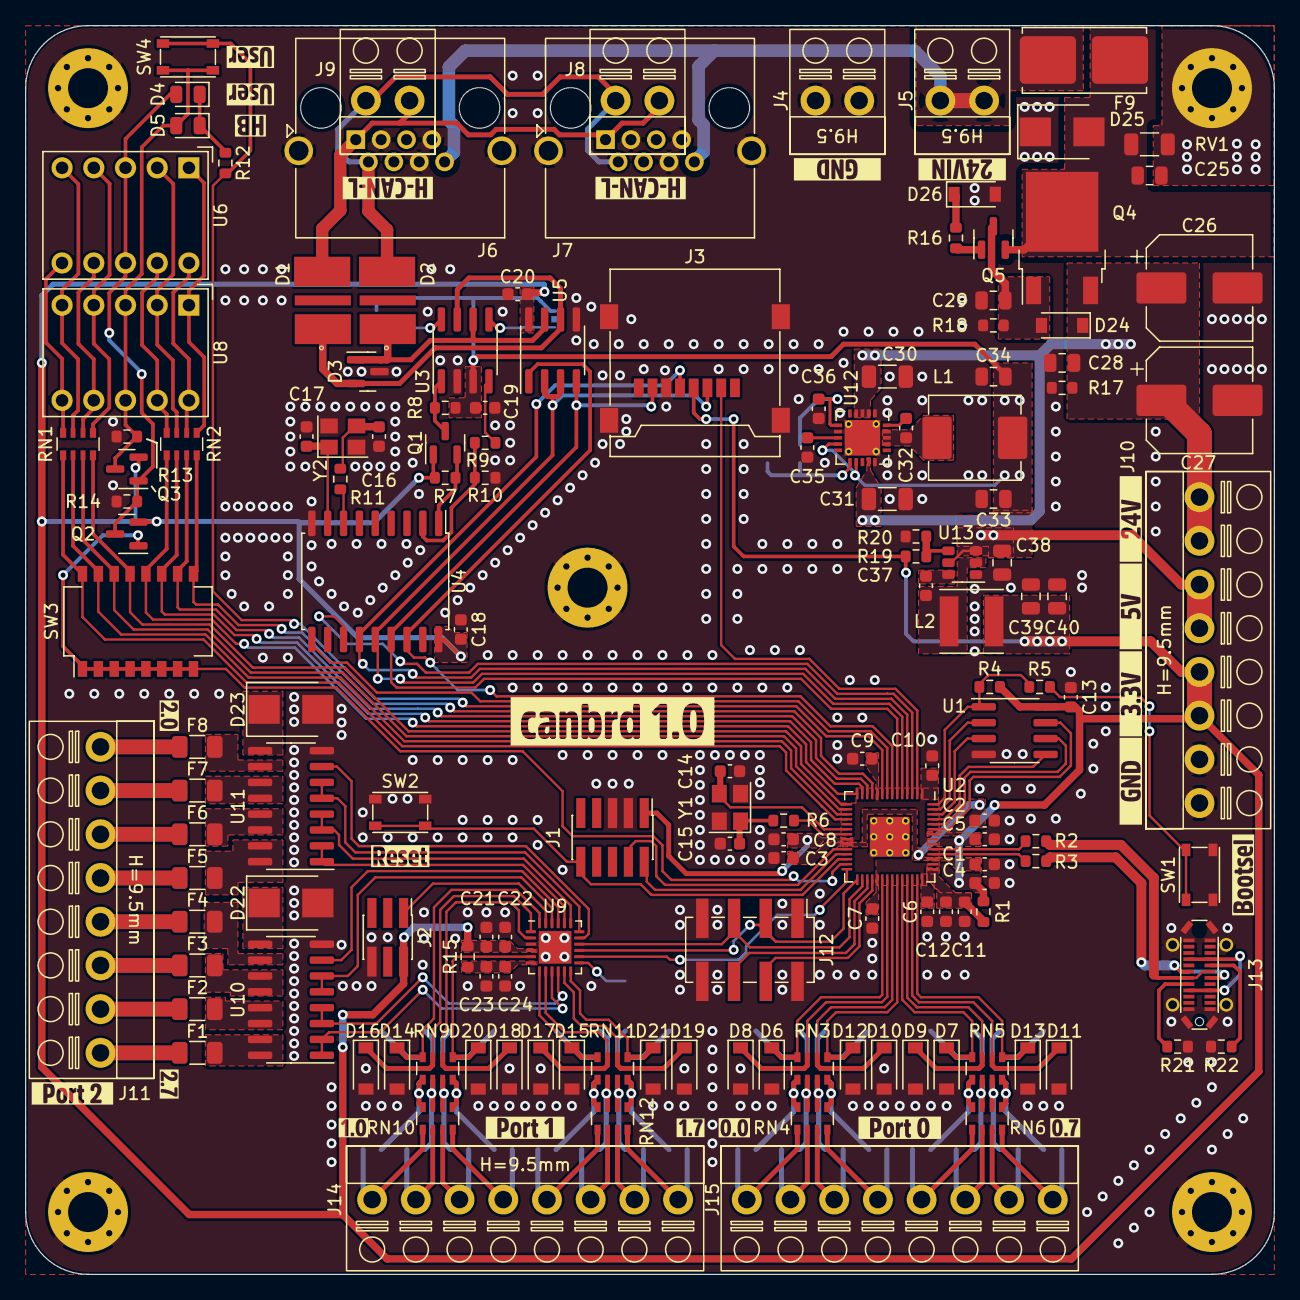
[picture p38: board hardware.kicad_pcb from above]

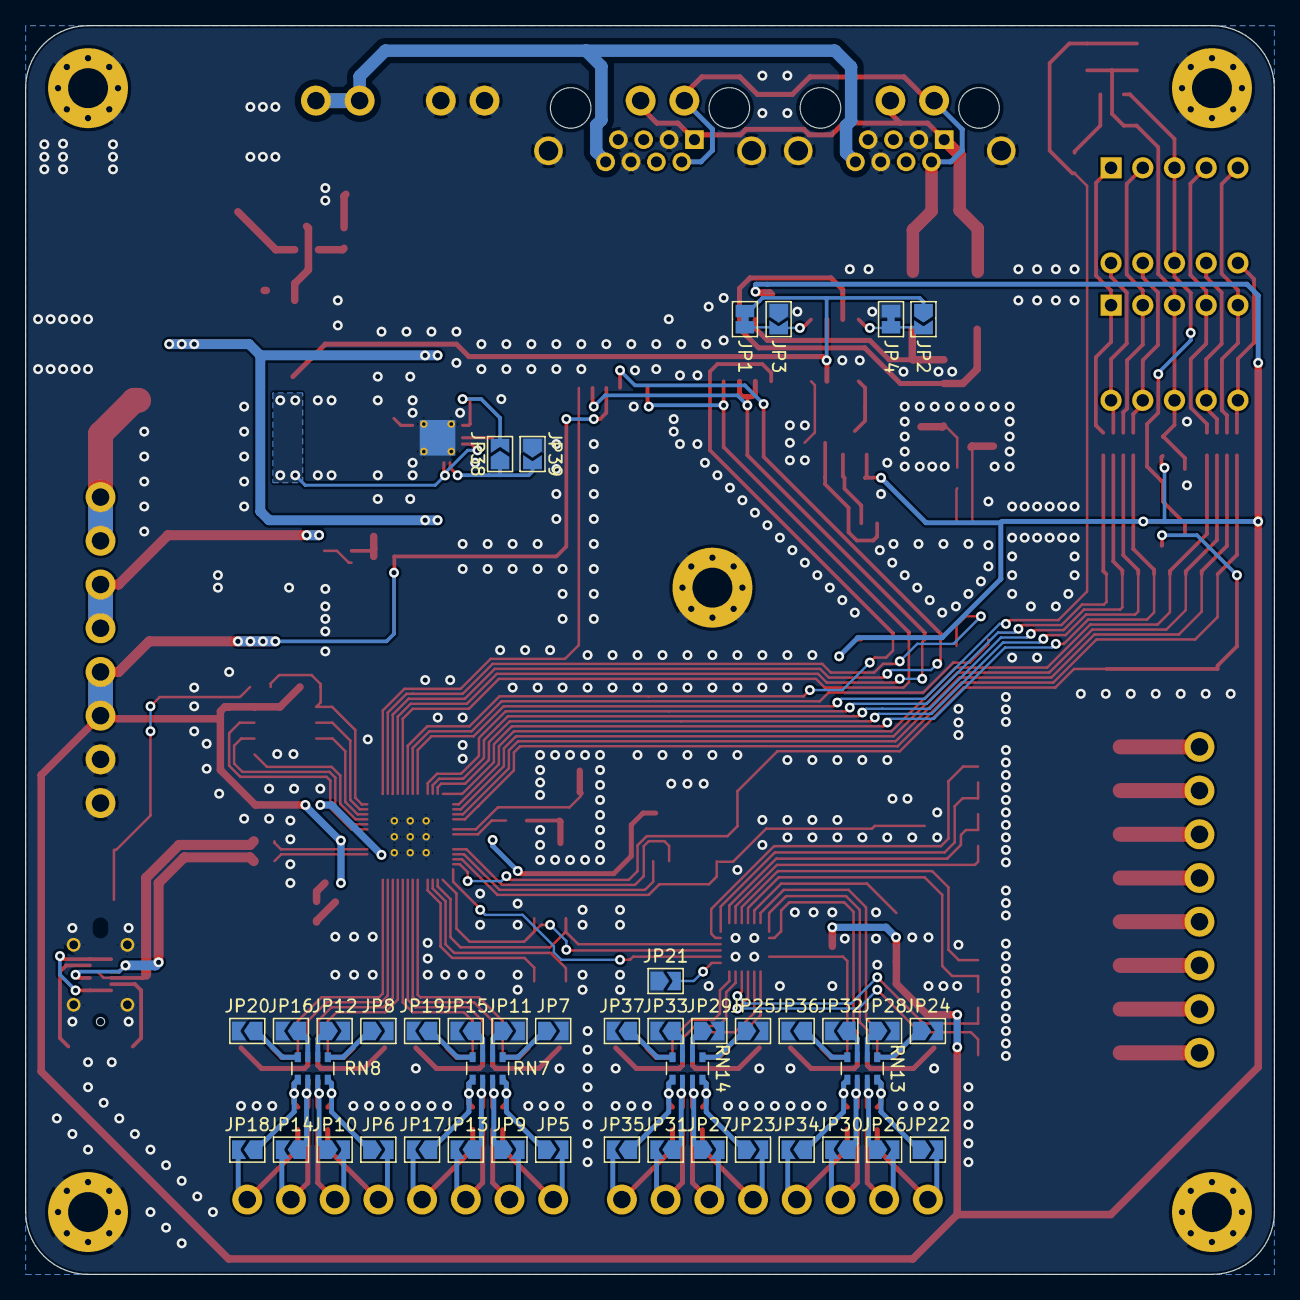
[picture p39: board hardware.kicad_pcb from below]

Board: 2 copper layers, 100.0 x 100.0 mm, 219 parts (43 on the bottom side), 178 nets.

Parts:
C1, C4, C11, C21, C23: 1u; C_0603_1608Metric
C2, C3, C5, C6, C7, C8, C9, C10, C12, C13, C18, C19, C20, C22, C24, C32, C37: 100n; C_0603_1608Metric
C14, C15, C16, C17: ???; C_0603_1608Metric
C25, C28, C29: 100n; C_0805_2012Metric
C26, C27: 47u; CP_Elec_8x6.5
C30, C31: 2.2u; C_1206_3216Metric
C33, C34, C39, C40: 22u; C_0805_2012Metric
C35: 5.6n; C_0603_1608Metric
C36: 2.2u; C_0603_1608Metric
C38: 10u; C_0805_2012Metric
D1, D2: TBU-CA; DIOC650X400X100N
D3: NUP2105L; SOT-23
D4: User; LED_0805_2012Metric
D5: Heartbeat; LED_0805_2012Metric
D6, D7, D8, D9, D10, D11, D12, D13, D14, D15, D16, D17, D18, D19, D20, D21: 3.3V; D_SOD-123
D22, D23, D25: 33V; D_SMB
D24: 10V; D_SOD-123
D26: 30V; D_SOD-123
F1, F2, F3, F5, F6, F7: 1A; Fuse_1206_3216Metric
F4, F8: 500mA; Fuse_1206_3216Metric
F9: 1A; Littelfuse-154
H1, H2, H3, H4, H5: M3; MountingHole_3.2mm_M3_Pad_Via
J1: RP_DEBUG; PinHeader_2x05_P1.27mm_Vertical_SMD
J2: UPDI; PinHeader_2x03_P1.27mm_Vertical_SMD
J3: Micro_SD_Card; GTFH081x1YHR
J4: GND; NH0210x0xxxxG
J5: Field24V; NH0210x0xxxxG
J6, J7: Amphenol RJHSE5380; RJ45_Amphenol_RJHSE5380
J8, J9: CAN; NH0210x0xxxxG
J10: PwrOut; NH0810x0xxxxG
J11: IO2; NH0810x0xxxxG
J12: I^{2}C; PinHeader_2x04_P2.54mm_Vertical_SMD
J13: USB_C_Receptacle; 10132328
J14: IO1; NH0810x0xxxxG
J15: IO0; NH0810x0xxxxG
JP1: Pin5H; SolderJumper-2_P1.3mm_Bridged_Pad1.0x1.5mm
JP2: Pin8H; SolderJumper-2_P1.3mm_Open_TrianglePad1.0x1.5mm
JP3: Pin5L; SolderJumper-2_P1.3mm_Open_TrianglePad1.0x1.5mm
JP4: Pin8L; SolderJumper-2_P1.3mm_Bridged_Pad1.0x1.5mm
JP5, JP6, JP9, JP10, JP13, JP14, JP17, JP18, JP22, JP23, JP26, JP27, JP30, JP31, JP34, JP35: LowZ; SolderJumper-2_P1.3mm_Open_TrianglePad1.0x1.5mm
JP7, JP8, JP11, JP12, JP15, JP16, JP19, JP20, JP24, JP25, JP28, JP29, JP32, JP33, JP36, JP37: Vdiv; SolderJumper-2_P1.3mm_Open_TrianglePad1.0x1.5mm
JP21: Addr; SolderJumper-2_P1.3mm_Open_TrianglePad1.0x1.5mm
JP38: DCM; SolderJumper-2_P1.3mm_Open_TrianglePad1.0x1.5mm
JP39: PWM; SolderJumper-2_P1.3mm_Open_TrianglePad1.0x1.5mm
L1: 6.8u; L_Abracon_ASPI-0630LR
L2: 2.2u; L_Taiyo-Yuden_NR-50xx
Q1: 2N7002K; SOT-23
Q2, Q3: BSS83P; SOT-23
Q4: Q_PMOS_GDS; TO-252-2
Q5: BC856; SOT-23
R1, R15: 220; R_0603_1608Metric
R2, R3: 27; R_0603_1608Metric
R4, R10, R17, R18, R20: 10k; R_0603_1608Metric
R5, R6, R7, R8, R11, R13, R14, R16: 1k; R_0603_1608Metric
R9: 4k7; R_0603_1608Metric
R12: 470; R_0603_1608Metric
R19: 31.6k; R_0603_1608Metric
R21, R22: 5.1k; R_0603_1608Metric
RN1, RN2: 470; R_Array_Convex_4x0603
RN3, RN5: 330; R_Array_Convex_4x0603
RN4, RN6, RN10, RN12: 10k; R_Array_Convex_4x0603
RN7, RN8, RN13, RN14: 1k; R_Array_Convex_4x0603
RN9, RN11: 68; R_Array_Convex_4x0603
RV1: 30V; R_1206_3216Metric
SW1: BOOTSEL; PTS815-SJ
SW2: RESET; PTS815-SJ
SW3: SW_DIP_x08; SW_DIP_SPSTx08_Slide_KingTek_DSHP08TS_W7.62mm_P1.27mm
SW4: User; PTS815-SJ
U1: W25Q16JVSNIQ; SOIC-8_3.9x4.9mm_P1.27mm
U2: RP2040; RP2040-QFN-56
U3: TJA1051T-3; SOIC-8_3.9x4.9mm_P1.27mm
U4: MCP2510-x/SO; SOIC-18W_7.5x11.6mm_P1.27mm
U5: MAX3485CSA; SOIC-8_3.9x4.9mm_P1.27mm
U6, U8: 157119S12801; Sx39-1xxxxx
U9: ATtiny427; QFN-24-1EP_4x4mm_P0.5mm_EP2.6x2.6mm
U10, U11: ULN2003A; SOIC-16_3.9x9.9mm_P1.27mm
U12: MAX17634BATP+; TQFN20-EP
U13: AP62250WU; TSOT26
Y1: 12MHz; Crystal_SMD_3225-4Pin_3.2x2.5mm
Y2: 16MHz; Crystal_SMD_3225-4Pin_3.2x2.5mm
kibuzzard-621B6EAC: G***; kibuzzard-621B6EAC
kibuzzard-621B6EB9: G***; kibuzzard-621B6EB9
kibuzzard-621B6EDA: G***; kibuzzard-621B6EDA
kibuzzard-6217A0B8: G***; kibuzzard-6217A0B8
kibuzzard-6217A0C8: G***; kibuzzard-6217A0C8
kibuzzard-6217A0EA: G***; kibuzzard-6217A0EA
kibuzzard-6217A003: G***; kibuzzard-6217A003
kibuzzard-6217A03E: G***; kibuzzard-6217A03E
kibuzzard-6217A08D: G***; kibuzzard-6217A08D
kibuzzard-6217A022: G***; kibuzzard-6217A022
kibuzzard-62179C2A: G***; kibuzzard-62179C2A
kibuzzard-62179C5E: G***; kibuzzard-62179C5E
kibuzzard-62179C9D: G***; kibuzzard-62179C9D
kibuzzard-62179CFC: G***; kibuzzard-62179CFC
kibuzzard-62179D4A: G***; kibuzzard-62179D4A
kibuzzard-62179E31: G***; kibuzzard-62179E31
kibuzzard-62179E98: G***; kibuzzard-62179E98
kibuzzard-62179EAF: G***; kibuzzard-62179EAF
kibuzzard-62179F8F: G***; kibuzzard-62179F8F
kibuzzard-62179F9F: G***; kibuzzard-62179F9F
kibuzzard-62179F21: G***; kibuzzard-62179F21
kibuzzard-62179FB2: G***; kibuzzard-62179FB2
kibuzzard-621788DF: G***; kibuzzard-621788DF

Connections:
+1V1: C1.1, C2.1, C3.1, U2.23 (DVDD), U2.45 (VREG_VOUT), U2.50 (DVDD)
+3.3VA: C11.1, C12.1, R1.2, U2.43 (ADC_AVDD)
+3.3VA2: C23.1, C24.1, R15.2, U9.6 (PA5)
+3V3: C4.1, C5.1, C6.1, C7.1, C8.1, C9.1, C10.1, C13.1, C18.1, C20.1, C21.1, C22.1, C39.1, C40.1, J1.1 (VTref), J2.2, J3.4 (VDD), J10.3, J10.4, L2.2, Q1.1 (G), Q2.2 (S), Q3.2 (S), R1.1, R4.1, R7.1, R15.1, R19.1, U1.8 (VCC), U2.1 (IOVDD), U2.10 (IOVDD), U2.22 (IOVDD), U2.33 (IOVDD), U2.42 (IOVDD), U2.44 (VREG_IN), U2.48 (USB_VDD), U2.49 (IOVDD), U4.18 (VDD), U5.8 (VCC), U9.4 (VCC)
+5V: C19.1, C33.1, C34.1, C38.1, J10.5, J10.6, JP1.2 (B), JP2.1 (A), L1.2, R8.1, U3.3 (VCC), U12.9 (FB), U12.12 (EXTVCC), U13.3 (VIN), U13.5 (EN)
+24V: C26.1, C27.1, C28.1, C30.1, C31.1, D24.1 (K), J10.7, J10.8, Q4.3 (S), R17.1, U12.2 (IN), U12.3 (IN), U12.4 (EN/UVLO), U12.14 (IN)
/CAN/CANH: D1.3, J6.1, J7.1, J8.1, J9.1
/CAN/CANL: D2.3, J6.2, J7.2, J8.2, J9.2
/CAN/CAN_OSC1: C17.2, U4.8 (OSC1), Y2.1
/CAN/CAN_OSC2: C16.2, R11.1, Y2.3
/CAN/CAN_Rx_HV: R9.2, U3.4 (RXD)
/CAN/CAN_Rx_LV: R9.1, R10.1, U4.2 (RXCAN)
/CAN/CAN_Tx_HV: Q1.3 (D), R8.2, U3.1 (TXD)
/CAN/CAN_Tx_LV: Q1.2 (S), R7.2, U4.1 (TXCAN)
/CAN/MISO: J3.7 (DAT0), U2.6 (GPIO4), U4.15 (SO), U5.4 (DI)
/CAN/MOSI: J3.3 (CMD), U2.5 (GPIO3), U4.14 (SI), U5.2 (~RE), U5.3 (DE)
/CAN/Pin5: JP1.1 (A), JP3.2 (B), U3.5 (VIO)
/CAN/Pin8: JP2.2 (B), JP4.1 (A), U3.8 (S)
/CAN/SCK: J3.5 (CLK), U2.4 (GPIO2), U4.13 (SCK)
/CAN/~CS: U2.7 (GPIO5), U4.16 (~CS), U5.1 (RO)
/CAN/~INT: U2.3 (GPIO1), U4.12 (~INT)
/CAN/~RX1: U2.8 (GPIO6), U4.10 (~RX1BF)
/Connectors/EXT.0: J12.6, U2.31 (GPIO20)
/Connectors/EXT.1: J12.4, U2.32 (GPIO21)
/Connectors/Field24V: F9.1, J5.1, J5.2, J6.8, J7.8
/Connectors/IO0.0: J15.1, JP5.2 (B), RN4.1 (R1.1)
/Connectors/IO0.1: J15.2, JP9.2 (B), RN4.2 (R2.1)
/Connectors/IO0.2: J15.3, JP13.2 (B), RN4.3 (R3.1)
/Connectors/IO0.3: J15.4, JP17.2 (B), RN4.4 (R4.1)
/Connectors/IO0.4: J15.5, JP6.2 (B), RN6.1 (R1.1)
/Connectors/IO0.5: J15.6, JP10.2 (B), RN6.2 (R2.1)
/Connectors/IO0.6: J15.7, JP14.2 (B), RN6.3 (R3.1)
/Connectors/IO0.7: J15.8, JP18.2 (B), RN6.4 (R4.1)
/Connectors/IO1.0: J14.1, JP22.2 (B), RN10.1 (R1.1)
/Connectors/IO1.1: J14.2, JP26.2 (B), RN10.2 (R2.1)
/Connectors/IO1.2: J14.3, JP30.2 (B), RN10.3 (R3.1)
/Connectors/IO1.3: J14.4, JP34.2 (B), RN10.4 (R4.1)
/Connectors/IO1.4: J14.5, JP23.2 (B), RN12.1 (R1.1)
/Connectors/IO1.5: J14.6, JP27.2 (B), RN12.2 (R2.1)
/Connectors/IO1.6: J14.7, JP31.2 (B), RN12.3 (R3.1)
/Connectors/IO1.7: J14.8, JP35.2 (B), RN12.4 (R4.1)
/Connectors/IO2.0: F8.2, J11.1
/Connectors/IO2.1: F7.2, J11.2
/Connectors/IO2.2: F6.2, J11.3
/Connectors/IO2.3: F5.2, J11.4
/Connectors/IO2.4: F4.2, J11.5
/Connectors/IO2.5: F3.2, J11.6
/Connectors/IO2.6: F2.2, J11.7
/Connectors/IO2.7: F1.2, J11.8
/Connectors/SCL: J12.5, U2.30 (GPIO19), U9.16 (PB0)
/Connectors/SDA: J12.3, U2.29 (GPIO18), U9.15 (PB1)
/Connectors/USB+: J13.A6 (D+), J13.B6 (D+), R2.2
/Connectors/USB-: J13.A7 (D-), J13.B7 (D-), R3.2
/DISP+SW/Dig: Q2.1 (G), SW3.1, SW3.2, SW3.3, SW3.4, SW3.5, SW3.6, SW3.7, SW3.8, U2.27 (GPIO16)
/DISP+SW/Seg.0: RN1.1 (R1.1), SW3.16, U2.18 (GPIO15)
/DISP+SW/Seg.1: RN1.2 (R2.1), SW3.15, U2.17 (GPIO14)
/DISP+SW/Seg.2: RN1.3 (R3.1), SW3.14, U2.16 (GPIO13)
/DISP+SW/Seg.3: RN1.4 (R4.1), SW3.13, U2.15 (GPIO12)
/DISP+SW/Seg.4: RN2.1 (R1.1), SW3.12, U2.14 (GPIO11)
/DISP+SW/Seg.5: RN2.2 (R2.1), SW3.11, U2.13 (GPIO10)
/DISP+SW/Seg.6: RN2.3 (R3.1), SW3.10, U2.12 (GPIO9)
/DISP+SW/Seg.7: RN2.4 (R4.1), SW3.9, U2.11 (GPIO8)
/DISP+SW/Seg.8: R12.2, SW4.2, U2.9 (GPIO7)
/DISP+SW/SegR.0: RN1.8 (R1.2), U6.6 (DP), U8.6 (DP)
/DISP+SW/SegR.1: RN1.7 (R2.2), U6.5 (D), U8.5 (D)
/DISP+SW/SegR.2: RN1.6 (R3.2), U6.7 (C), U8.7 (C)
/DISP+SW/SegR.3: RN1.5 (R4.2), U6.4 (E), U8.4 (E)
/DISP+SW/SegR.4: RN2.8 (R1.2), U6.9 (B), U8.9 (B)
/DISP+SW/SegR.5: RN2.7 (R2.2), U6.2 (F), U8.2 (F)
/DISP+SW/SegR.6: RN2.6 (R3.2), U6.10 (A), U8.10 (A)
/DISP+SW/SegR.7: RN2.5 (R4.2), U6.1 (G), U8.1 (G)
/DISP+SW/SegR.8: D4.1 (K), D5.1 (K), R12.1
/DISP+SW/nDig: D4.2 (A), Q2.3 (D), Q3.1 (G), R14.1, U6.3 (CA), U6.8 (CA)
/DISP+SW/~nDig: D5.2 (A), Q3.3 (D), R13.1, SW4.1, U8.3 (CA), U8.8 (CA)
/IO Expander/AT_ADDR: JP21.2 (B), U9.13 (PB3)
/IO Expander/AT_~INT: U2.28 (GPIO17), U9.14 (PB2)
/IO Expander/IO Expander Power IO/AT2.0: U9.17 (PC0), U11.7 (I7)
/IO Expander/IO Expander Power IO/AT2.1: U9.18 (PC1), U11.5 (I5), U11.6 (I6)
/IO Expander/IO Expander Power IO/AT2.2: U9.19 (PC2), U11.3 (I3), U11.4 (I4)
/IO Expander/IO Expander Power IO/AT2.3: U9.20 (PC3), U11.1 (I1), U11.2 (I2)
/IO Expander/IO Expander Power IO/AT2.4: U9.21 (PC4), U10.7 (I7)
/IO Expander/IO Expander Power IO/AT2.5: U9.22 (PC5), U10.5 (I5), U10.6 (I6)
/IO Expander/IO Expander Power IO/AT2.6: U9.10 (PB6), U10.3 (I3), U10.4 (I4)
/IO Expander/IO Expander Power IO/AT2.7: U9.9 (PB7), U10.1 (I1), U10.2 (I2)
/IO Expander/IO Expander Power IO/COM0: D22.1 (A1), U10.9 (COM)
/IO Expander/IO Expander Power IO/COM1: D23.1 (A1), U11.9 (COM)
/IO Expander/IO Expander Power IO/HC0: F1.1, U10.15 (O2), U10.16 (O1)
/IO Expander/IO Expander Power IO/HC1: F2.1, U10.13 (O4), U10.14 (O3)
/IO Expander/IO Expander Power IO/HC2: F3.1, U10.11 (O6), U10.12 (O5)
/IO Expander/IO Expander Power IO/HC3: F4.1, U10.10 (O7)
/IO Expander/IO Expander Power IO/HC4: F5.1, U11.15 (O2), U11.16 (O1)
/IO Expander/IO Expander Power IO/HC5: F6.1, U11.13 (O4), U11.14 (O3)
/IO Expander/IO Expander Power IO/HC6: F7.1, U11.11 (O6), U11.12 (O5)
/IO Expander/IO Expander Power IO/HC7: F8.1, U11.10 (O7)
/IO Expander/IO Expander Protection/AT1.0: D14.1 (K), RN9.8 (R1.2), U9.24 (PA1)
/IO Expander/IO Expander Protection/AT1.1: D16.1 (K), RN9.7 (R2.2), U9.1 (PA2)
/IO Expander/IO Expander Protection/AT1.2: D18.1 (K), RN9.6 (R3.2), U9.2 (PA3)
/IO Expander/IO Expander Protection/AT1.3: D20.1 (K), RN9.5 (R4.2), U9.5 (PA4)
/IO Expander/IO Expander Protection/AT1.4: D15.1 (K), RN11.8 (R1.2), U9.7 (PA6)
/IO Expander/IO Expander Protection/AT1.5: D17.1 (K), RN11.7 (R2.2), U9.8 (PA7)
/IO Expander/IO Expander Protection/AT1.6: D19.1 (K), RN11.6 (R3.2), U9.11 (PB5)
/IO Expander/IO Expander Protection/AT1.7: D21.1 (K), RN11.5 (R4.2), U9.12 (PB4)
/IO Expander/UPDI: J2.1, U9.23 (~RESET/PA0)
/IO/RP0: D6.1 (K), RN3.8 (R1.2), U2.34 (GPIO22)
/IO/RP1: D8.1 (K), RN3.7 (R2.2), U2.35 (GPIO23)
/IO/RP2: D10.1 (K), RN3.6 (R3.2), U2.36 (GPIO24)
/IO/RP3: D12.1 (K), RN3.5 (R4.2), U2.37 (GPIO25)
/IO/RP4: D7.1 (K), RN5.8 (R1.2), U2.38 (GPIO26_ADC0)
/IO/RP5: D9.1 (K), RN5.7 (R2.2), U2.39 (GPIO27_ADC1)
/IO/RP6: D11.1 (K), RN5.6 (R3.2), U2.40 (GPIO28_ADC2)
/IO/RP7: D13.1 (K), RN5.5 (R4.2), U2.41 (GPIO29_ADC3)
/MCU/QSPI_CLK: U1.6 (CLK), U2.52 (QSPI_SCLK)
/MCU/QSPI_IO0: U1.5 (DI/IO0), U2.53 (QSPI_SD0)
/MCU/QSPI_IO1: U1.2 (DO/IO1), U2.55 (QSPI_SD1)
/MCU/QSPI_IO2: U1.3 (~WP/IO2), U2.54 (QSPI_SD2)
/MCU/QSPI_IO3: U1.7 (~HOLD/IO3), U2.51 (QSPI_SD3)
/MCU/QSPI_~CS: R4.2, R5.1, U1.1 (~CS), U2.56 (QSPI_SS)
/MCU/RP_SWCLK: J1.4 (SWDCLK/TCK), U2.24 (SWCLK)
/MCU/RP_SWDIO: J1.2 (SWDIO/TMS), U2.25 (SWD)
/MCU/RP_XIN: C14.2, U2.20 (XIN), Y1.3
/MCU/RP_XOUT: C15.2, R6.1, Y1.1
/MCU/RP_~RESET: J1.10 (~RESET), SW2.2, U2.26 (RUN)
/MCU/SD_~CS: J3.2 (DAT3/CD), U2.2 (GPIO0)
/MCU/USB_XDM: R3.1, U2.46 (USB_DM)
/MCU/USB_XDP: R2.1, U2.47 (USB_DP)
/MCU/~BOOTSEL: R5.2, SW1.1
/Power/AP_BST: C37.1, U13.6 (BST)
/Power/AP_FB: R19.2, R20.1, U13.4 (FB)
/Power/Fused24V: C25.1, D25.2 (A2), F9.2, Q4.2 (D), Q5.2 (E), RV1.1
/Power/MAX_BST: C32.1, U12.20 (BST)
/Power/MAX_INTVCC: C36.1, JP38.2 (B), U12.6 (INTVCC)
/Power/MAX_LX: C32.2, L1.1, U12.17 (LX), U12.18 (LX), U12.19 (LX)
/Power/MAX_MODE: JP38.1 (A), JP39.2 (B), U12.11 (MODE/SYNC)
/Power/MAX_SS: C35.1, U12.8 (SS)
/Power/SW3v3: C37.2, L2.1, U13.2 (SW)
/Power/revprot_gate: C29.1, D24.2 (A), Q4.1 (G), Q5.3 (C), R18.1
GND: C1.2, C2.2, C3.2, C4.2, C5.2, C6.2, C7.2, C8.2, C9.2, C10.2, C11.2, C12.2, C13.2, C14.1, C15.1, C16.1, C17.1, C18.2, C19.2, C20.2, C21.2, C22.2, C23.2, C24.2, C25.2, C26.2, C27.2, C28.2, C29.2, C30.2, C31.2, C33.2, C34.2, C35.2, C36.2, C38.2, C39.2, C40.2, D3.3 (A), D6.2 (A), D7.2 (A), D8.2 (A), D9.2 (A), D10.2 (A), D11.2 (A), D12.2 (A), D13.2 (A), D14.2 (A), D15.2 (A), D16.2 (A), D17.2 (A), D18.2 (A), D19.2 (A), D20.2 (A), D21.2 (A), D22.2 (A2), D23.2 (A2), D25.1 (A1), D26.2 (A), H1.1, H2.1, H3.1, H4.1, H5.1, J1.3 (GND), J1.5 (GND), J2.6, J3.6 (VSS), J3.9 (SHIELD), J4.1, J4.2, J6.3, J6.6, J6.7, J6.SH, J7.3, J7.6, J7.7, J7.SH, J10.1, J10.2, J12.1, J12.2, J12.7, J12.8, J13.A1 (GND), J13.A12 (GND), J13.B1 (GND), J13.B12 (GND), J13.S1 (SHIELD), JP3.1 (A), JP4.2 (B), JP7.2 (B), JP8.2 (B), JP11.2 (B), JP12.2 (B), JP15.2 (B), JP16.2 (B), JP19.2 (B), JP20.2 (B), JP21.1 (A), JP24.2 (B), JP25.2 (B), JP28.2 (B), JP29.2 (B), JP32.2 (B), JP33.2 (B), JP36.2 (B), JP37.2 (B), JP39.1 (A), R10.2, R13.2, R14.2, R17.2, R18.2, R20.2, R21.2, R22.2, RV1.2, SW1.2, SW2.1, U1.4 (GND), U2.19 (TESTEN), U2.57 (GND), U3.2 (GND), U4.9 (VSS), U5.5 (GND), U9.3 (GND), U9.25 (GND), U10.8 (GND), U11.8 (GND), U12.1 (PGND), U12.7 (SGND), U12.15 (PGND), U12.21 (EXP), U13.1 (GND), Y1.2, Y1.4, Y2.2, Y2.4
unnamed: D1.1, D3.2 (K), U3.7 (CANH), U5.6 (A)
unnamed: D2.1, D3.1 (K), U3.6 (CANL), U5.7 (B)
unnamed: D26.1 (K), R16.1
unnamed: J13.A5 (CC1), R21.1
unnamed: J13.B5 (CC2), R22.1
unnamed: JP5.1 (A), RN3.1 (R1.1), RN4.8 (R1.2), RN7.8 (R1.2)
unnamed: JP6.1 (A), RN5.1 (R1.1), RN6.8 (R1.2), RN8.8 (R1.2)
unnamed: JP7.1 (A), RN7.1 (R1.1)
unnamed: JP8.1 (A), RN8.1 (R1.1)
unnamed: JP9.1 (A), RN3.2 (R2.1), RN4.7 (R2.2), RN7.7 (R2.2)
unnamed: JP10.1 (A), RN5.2 (R2.1), RN6.7 (R2.2), RN8.7 (R2.2)
unnamed: JP11.1 (A), RN7.2 (R2.1)
unnamed: JP12.1 (A), RN8.2 (R2.1)
unnamed: JP13.1 (A), RN3.3 (R3.1), RN4.6 (R3.2), RN7.6 (R3.2)
unnamed: JP14.1 (A), RN5.3 (R3.1), RN6.6 (R3.2), RN8.6 (R3.2)
unnamed: JP15.1 (A), RN7.3 (R3.1)
unnamed: JP16.1 (A), RN8.3 (R3.1)
unnamed: JP17.1 (A), RN3.4 (R4.1), RN4.5 (R4.2), RN7.5 (R4.2)
unnamed: JP18.1 (A), RN5.4 (R4.1), RN6.5 (R4.2), RN8.5 (R4.2)
unnamed: JP19.1 (A), RN7.4 (R4.1)
unnamed: JP20.1 (A), RN8.4 (R4.1)
unnamed: JP22.1 (A), RN9.1 (R1.1), RN10.8 (R1.2), RN13.8 (R1.2)
unnamed: JP23.1 (A), RN11.1 (R1.1), RN12.8 (R1.2), RN14.8 (R1.2)
unnamed: JP24.1 (A), RN13.1 (R1.1)
unnamed: JP25.1 (A), RN14.1 (R1.1)
unnamed: JP26.1 (A), RN9.2 (R2.1), RN10.7 (R2.2), RN13.7 (R2.2)
unnamed: JP27.1 (A), RN11.2 (R2.1), RN12.7 (R2.2), RN14.7 (R2.2)
unnamed: JP28.1 (A), RN13.2 (R2.1)
unnamed: JP29.1 (A), RN14.2 (R2.1)
unnamed: JP30.1 (A), RN9.3 (R3.1), RN10.6 (R3.2), RN13.6 (R3.2)
unnamed: JP31.1 (A), RN11.3 (R3.1), RN12.6 (R3.2), RN14.6 (R3.2)
unnamed: JP32.1 (A), RN13.3 (R3.1)
unnamed: JP33.1 (A), RN14.3 (R3.1)
unnamed: JP34.1 (A), RN9.4 (R4.1), RN10.5 (R4.2), RN13.5 (R4.2)
unnamed: JP35.1 (A), RN11.4 (R4.1), RN12.5 (R4.2), RN14.5 (R4.2)
unnamed: JP36.1 (A), RN13.4 (R4.1)
unnamed: JP37.1 (A), RN14.4 (R4.1)
unnamed: Q5.1 (B), R16.2
unnamed: R6.2, U2.21 (XOUT)
unnamed: R11.2, U4.7 (OSC2)
VBUS: J13.A4 (VBUS), J13.A9 (VBUS), J13.B4 (VBUS), J13.B9 (VBUS)
