BME-SBT/canbrd_hardware/(commit log)

2022-01-28 started routing
    [STP_WL-T7DS_0_39 (rev1).stp, SiC462ED-T1-GE3.stl, SiC462ED-T1-GE3.stp, can.kicad_sch, conn.kicad_sch, hardware.kicad_pcb, hardware.kicad_sch, io.kicad_sch]
2022-02-24 Add version, date
    [can.kicad_sch, conn.kicad_sch, hardware.kicad_pcb, hardware.kicad_sch, io.kicad_sch, io_expander.kicad_sch, io_expander_powerio.kicad_sch, io_expander_protection.kicad_sch]
2022-02-27 WIP: display
    [hardware.kicad_pcb, hardware.kicad_sch, io_expander.kicad_sch, io_expander_powerio.kicad_sch, mcu.kicad_sch, onboard.kicad_sch, power.kicad_sch]
2022-02-28 Done. I hope.
    [hardware.kicad_sch, onboard.kicad_sch]
2022-03-07 Should be final
    [hardware.kicad_pcb, hardware.kicad_sch, power.kicad_sch]
2022-03-18 rev1.1: Add I2C pullups
    [can.kicad_sch, canbrd.kicad_pcb, canbrd.kicad_sch, conn.kicad_sch, io.kicad_sch, io_expander.kicad_sch, io_expander_powerio.kicad_sch, io_expander_protection.kicad_sch]
2022-04-10 lots changed
    [can.kicad_sch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]
2022-04-11 things changed
    [canbrd.kicad_pcb]
2022-04-11 Update gerber
    [canbrd-B_Cu.gbr, canbrd-B_Mask.gbr, canbrd-B_Paste.gbr, canbrd-B_Silkscreen.gbr, canbrd-Edge_Cuts.gbr, canbrd-F_Cu.gbr, canbrd-F_Mask.gbr, canbrd-F_Paste.gbr]
2022-06-03 isolate and other stuff
    [can.kicad_sch, canbrd.kicad_pcb, canbrd.kicad_sch, conn.kicad_sch, io.kicad_sch, io_expander.kicad_sch, isolation.kicad_sch, mcu.kicad_sch]
2023-02-06 Minimal design for testing
    [adc.kicad_sch, can.kicad_sch, canbrd.kicad_sch, conn.kicad_sch, io_expander.kicad_sch, power.kicad_sch]
