BME-SBT/canbrd_hardware/(notices)

Notices in the files:
parts/PTS815-SJ/PTS815SJM250SMTRLFS.stp:
FILE_NAME( 'e:/temp/worker_57/temp/exporttempdir_5040_103_JhYAO/format_0/PTS815SJM250SMTRLFS.stp', '2022-01-14T14:14:18', ( 'License CC BY-ND 4.0' ), ( 'CADENAS' ), ' ', 'PARTsolutions', ' ' );
